AIYILIN/Robotic_Arm/2.Firmware/lckfb-hspi-d133ebs/readme.md

ui_builder
放置：
luban-lite\packages\artinchip\lvgl-ui\aic_demo\ui_builder
