AIYILIN/Robotic_Arm/6.Docs/unitree/GO-M8010-6电机使用教程/STM32平台教程/README.txt

1.本例程使用的单片机型号为STM32F767ZITx
2.使用本例程前需准备TTL转485模块(可在宇树官网或电商平台购买)
3.参考GO2电机TTL转485模组资料连接通信和电源线路
4.在使用其他单片机时需要先确认串口波特率是否满足4000000
5.对电机通信的文件进行移植
