AIYILIN/Robotic_Arm/2.Firmware/lckfb-hspi-d133ebs/aiui/AIUI_demo/resources/image/goodson.jpg

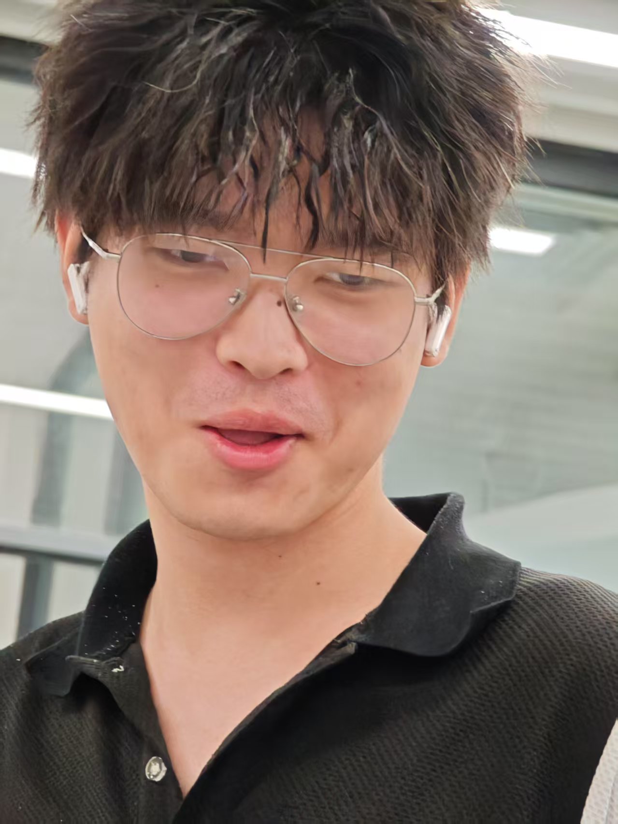
2.Firmware/lckfb-hspi-d133ebs/aiui/AIUI_demo/resources/image/goodson.jpg
