AIYILIN/Robotic_Arm/6.Docs/unitree/GO-M8010-6电机使用教程/STM32平台教程/GO2电机TTL转485模组资料/1_硬件开发资料_集成库文件/集成库全部器件3D预览2.jpg

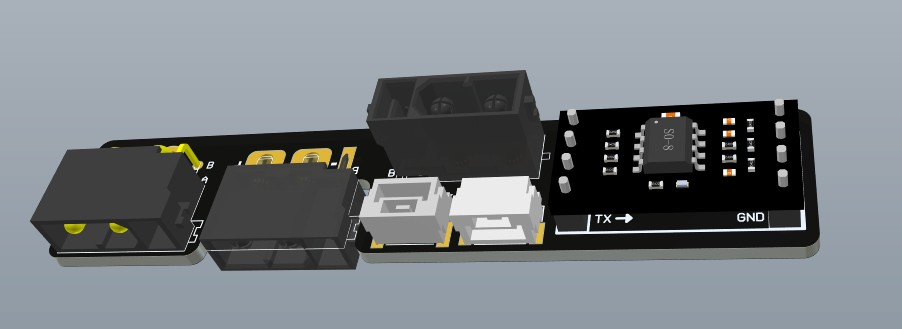
6.Docs/unitree/GO-M8010-6电机使用教程/STM32平台教程/GO2电机TTL转485模组资料/1_硬件开发资料_集成库文件/集成库全部器件3D预览2.jpg
