AIYILIN/Robotic_Arm/6.Docs/unitree/GO-M8010-6电机使用教程/STM32平台教程/GO2电机TTL转485模组资料/2_模组说明文档_附图/1-1A 模组应用接线示例.jpg

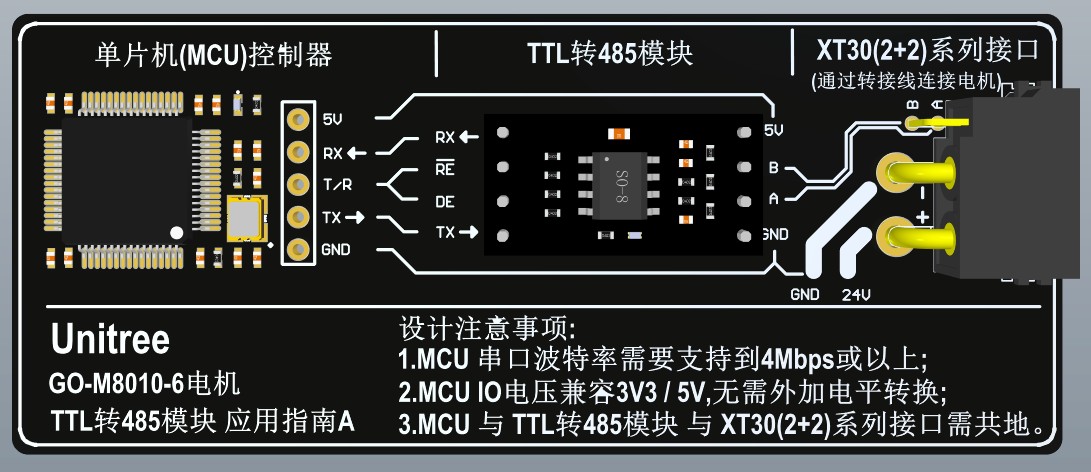
6.Docs/unitree/GO-M8010-6电机使用教程/STM32平台教程/GO2电机TTL转485模组资料/2_模组说明文档_附图/1-1A 模组应用接线示例.jpg
