AIYILIN/Robotic_Arm/6.Docs/unitree/GO-M8010-6电机使用教程/STM32平台教程/GO2电机TTL转485模组资料/2_模组说明文档_附图/1-3 模组TTL接口功能明细.png

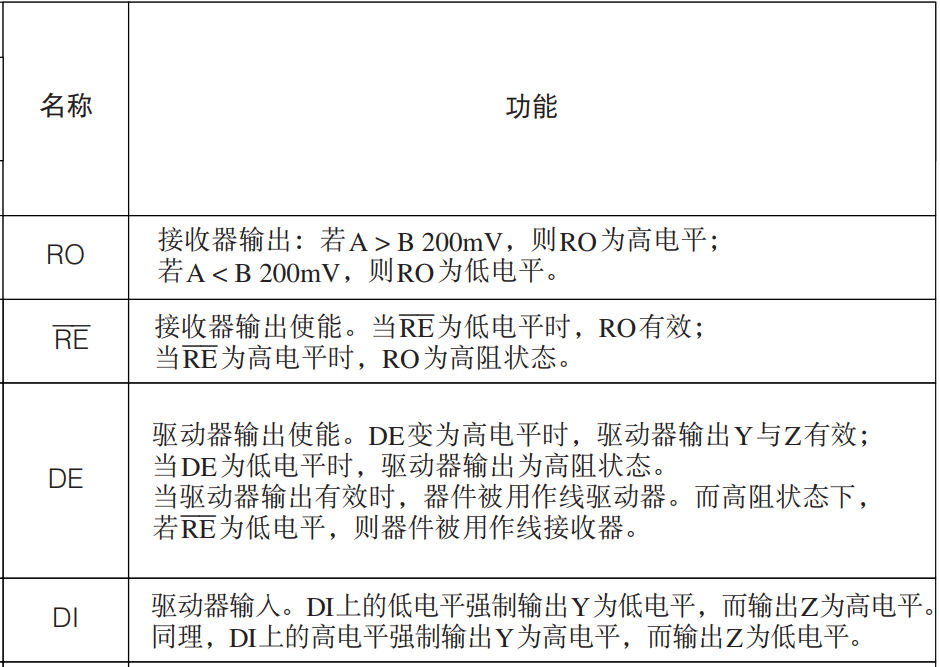
6.Docs/unitree/GO-M8010-6电机使用教程/STM32平台教程/GO2电机TTL转485模组资料/2_模组说明文档_附图/1-3 模组TTL接口功能明细.png
