AIYILIN/Robotic_Arm/5.3D Model/reducer-master/42/42电机减速机第四版/零件清单.xls

物料 | 数量
轴承 6706-ZZ【30*37*4】 | 1
轴承 内径12外径18厚度4 | 1
轴承 内径15外径21厚度4 | 1
注塑铜螺母滚花螺母 M3*6*4.2 | 10
注塑铜螺母滚花螺母 M2*6*3.2 | 4
钢圆头内六角螺丝圆柱螺钉 M2*35 (https://item.taobao.com/item.htm?spm=a1z09.2.0.0.6c082e8d8Twp98&id=664122354131&_u=ovv76ou61e7) | 4
3D 打印件
304不锈钢球轴承滚珠不锈钢钢珠实心钢珠精密小钢珠钢球2.0毫米 (https://item.taobao.com/item.htm?spm=a1z09.2.0.0.6c082e8dgtaKx1&id=617921831316&_u=qvv76oud0d6) | 45~55颗
润滑油 | 1
500目砂纸 | 1
