AIYILIN/Robotic_Arm/5.3D Model/reducer-master/42/42电机减速机第四版/42电机总成第四版底无轴.SLDASM

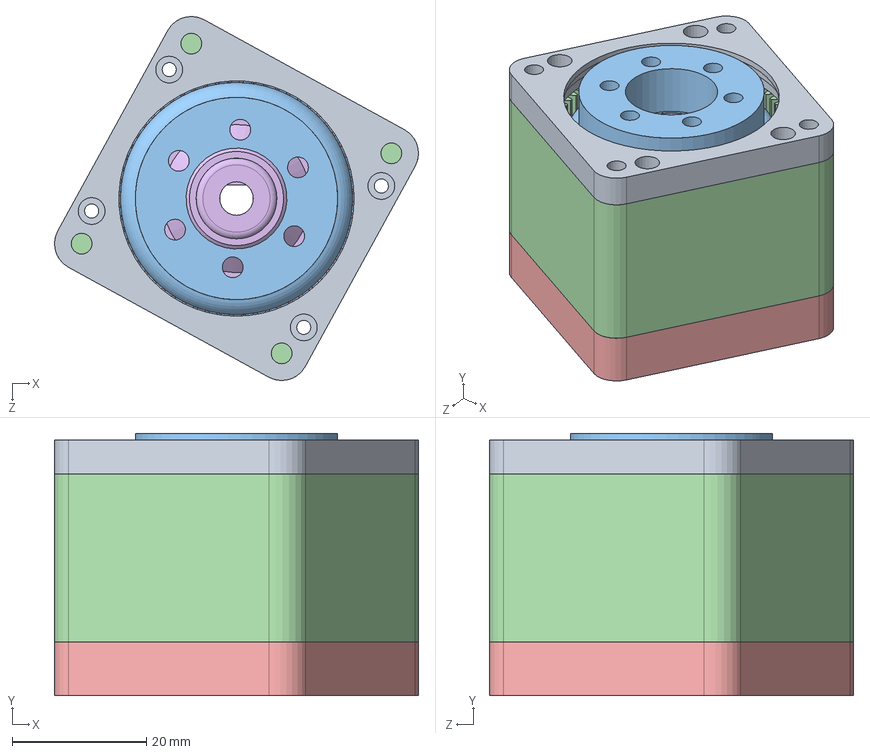
[picture p71: CAD file, 2025-01-31]
5.3D Model/reducer-master/42/42电机减速机第四版/42电机总成第四版底无轴.SLDASM
54.2 x 39.0 x 54.2 mm
42波发生器第四版底部中空
42底盖第四版
42钢轮第四版
42柔轮第四版
42柔轮内第四版
42顶盖第四版
