AIYILIN/Robotic_Arm/5.3D Model/reducer-master/28/28电机减速电机.SLDASM

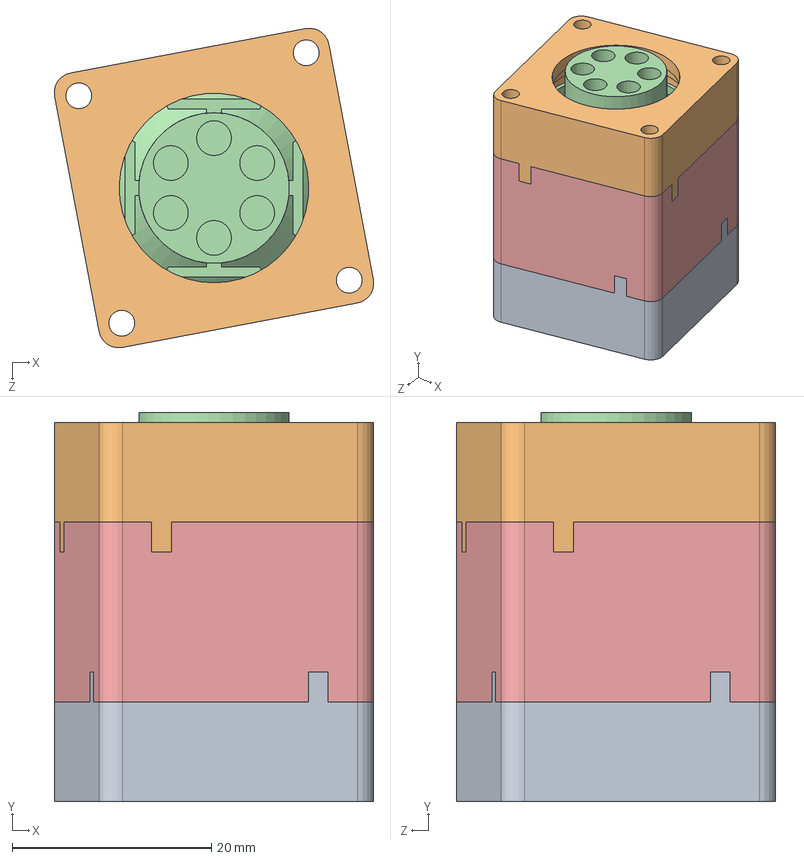
[picture p73: CAD file, 2025-01-31]
5.3D Model/reducer-master/28/28电机减速电机.SLDASM
32.0 x 39.0 x 32.0 mm
波发生器改
底座改
柔轮改
柔轮内改
顶盖改
底盖改
