AIYILIN/Robotic_Arm/5.3D Model/3-4轴连接.step

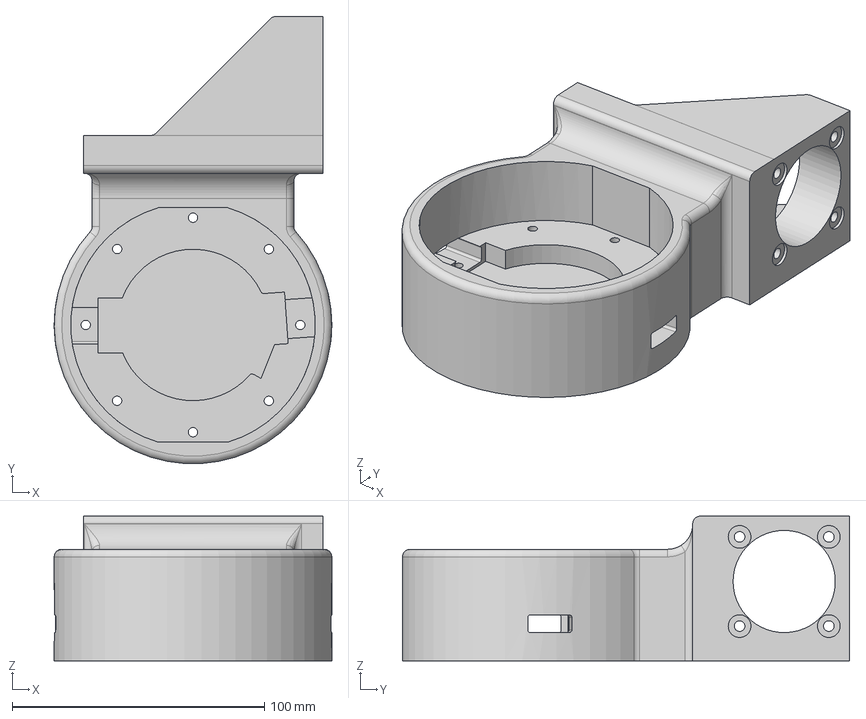
[picture p74: CAD file, 2025-02-12]
5.3D Model/3-4轴连接.step
110.0 x 177.1 x 57.3 mm
