AIYILIN/Robotic_Arm/5.3D Model/cnc/cnc2-3.step

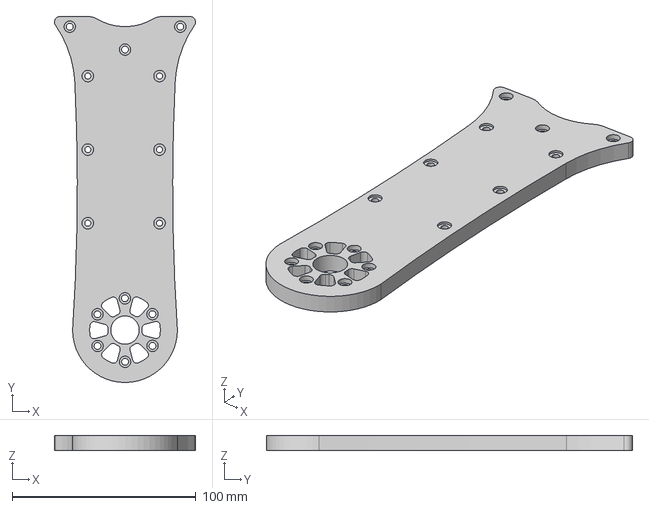
[picture p75: CAD file, 2025-02-06]
5.3D Model/cnc/cnc2-3.step
76.7 x 199.0 x 8.00 mm
