AIYILIN/Robotic_Arm/5.3D Model/reducer-master/42/42电机减速机第三版/42波发生器第三版.SLDPRT

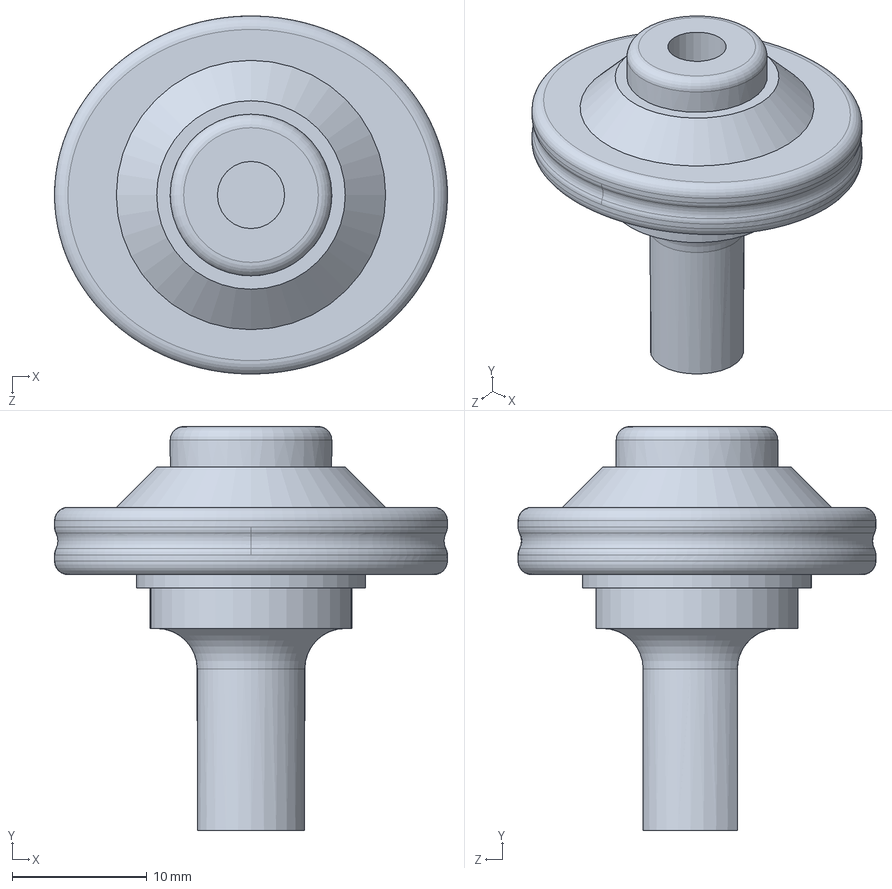
[picture p77: CAD file, 2025-01-31]
5.3D Model/reducer-master/42/42电机减速机第三版/42波发生器第三版.SLDPRT
29.2 x 30.0 x 26.6 mm
