AIYILIN/Robotic_Arm/5.3D Model/reducer-master/42/42电机减速机第三版/step/42减速器第三版总成.STEP

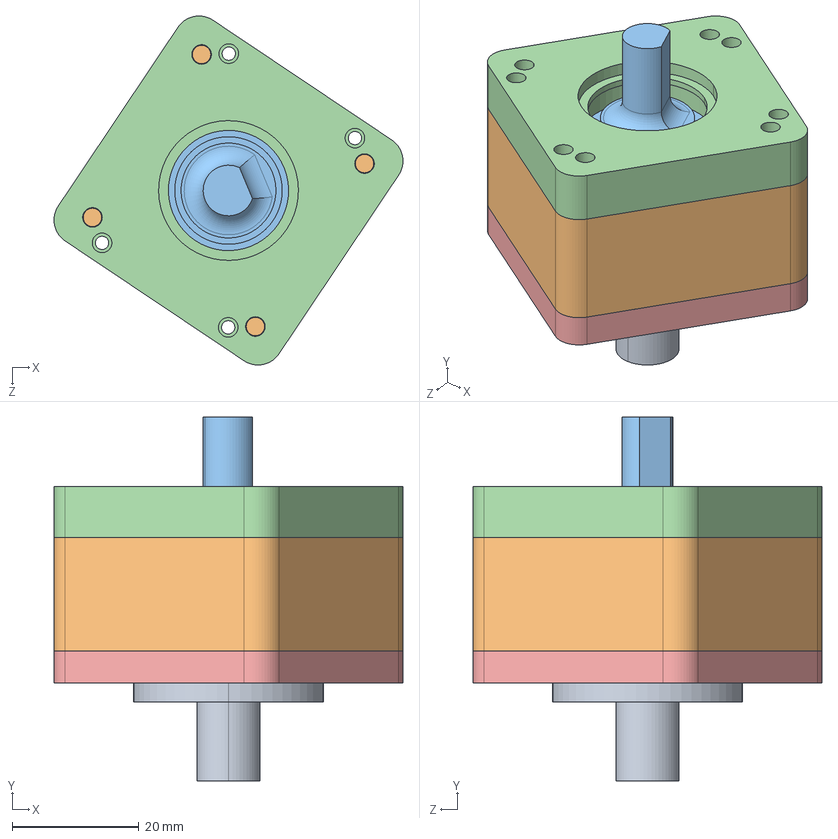
[picture p78: CAD file, 2025-01-31]
5.3D Model/reducer-master/42/42电机减速机第三版/step/42减速器第三版总成.STEP
55.2 x 57.5 x 55.2 mm
42柔轮第三版
42钢轮第三版
42波发生器第三版
42底盖第三版
42顶盖第三版
42柔轮内第三版
