AIYILIN/Robotic_Arm/5.3D Model/reducer-master/42/42电机减速机第二版/42顶盖第二版.SLDPRT

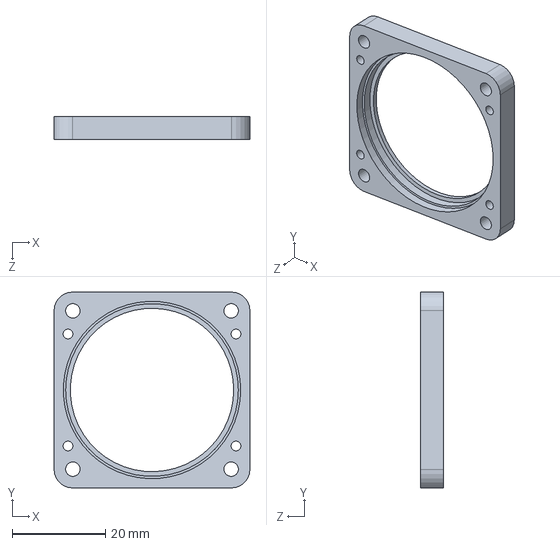
[picture p79: CAD file, 2025-01-31]
5.3D Model/reducer-master/42/42电机减速机第二版/42顶盖第二版.SLDPRT
42.0 x 42.0 x 5.00 mm
