AIYILIN/Robotic_Arm/5.3D Model/reducer-master/42/42电机减速机第二版/step/42减速器总成.STEP

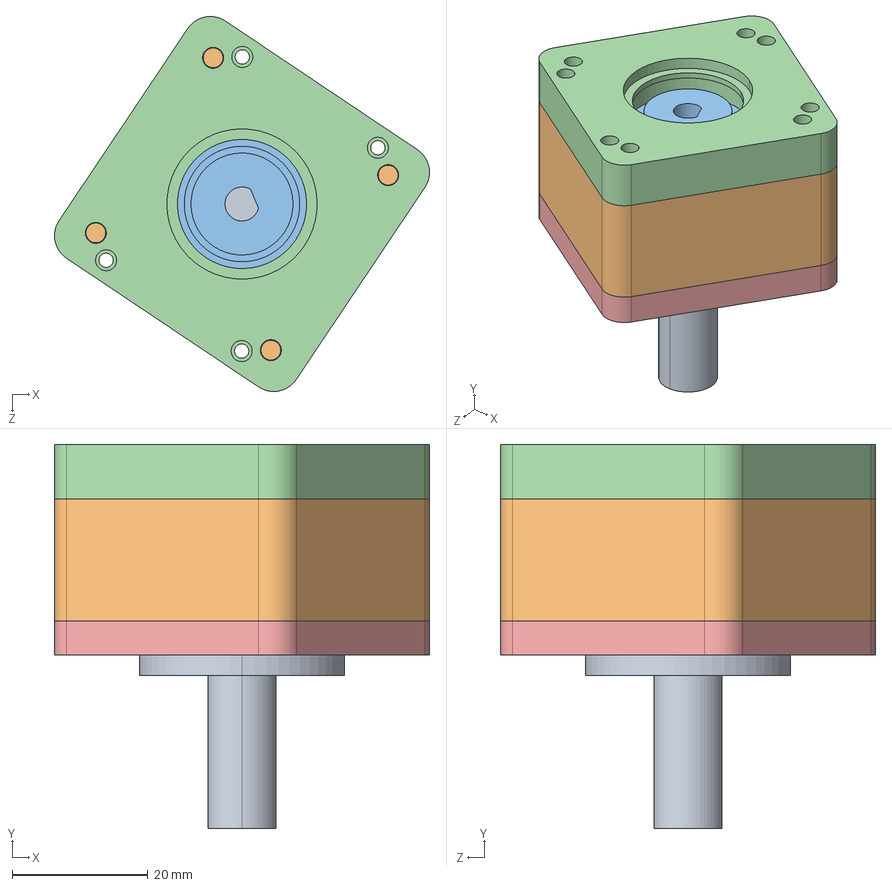
[picture p80: CAD file, 2025-01-31]
5.3D Model/reducer-master/42/42电机减速机第二版/step/42减速器总成.STEP
55.2 x 56.5 x 55.2 mm
42柔轮第二版
42钢轮第二版
42波发生器第二版
42底盖第二版
42顶盖第二版
42柔轮内第二版
