AIYILIN/Robotic_Arm/5.3D Model/reducer-master/42/42电机减速机第二版/stl/柔轮内.STL

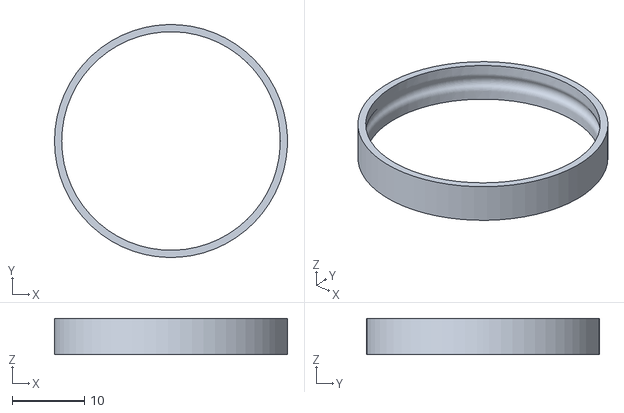
[picture p81: CAD file, 2025-01-31]
5.3D Model/reducer-master/42/42电机减速机第二版/stl/柔轮内.STL
32.2 x 32.2 x 5.00
