AIYILIN/Robotic_Arm/5.3D Model/手爪V1.0/顶端轴承固定件.SLDPRT

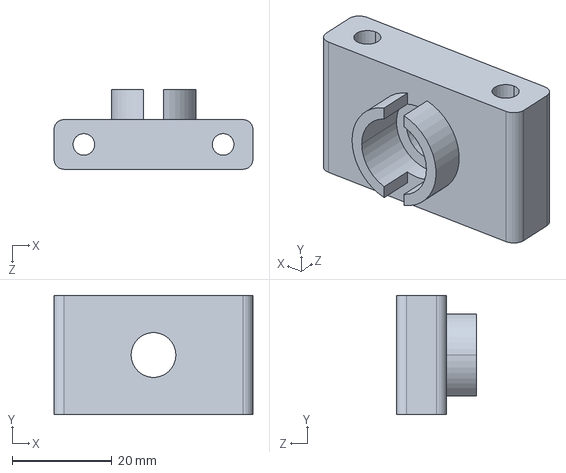
[picture p82: CAD file, 2025-05-13]
5.3D Model/手爪V1.0/顶端轴承固定件.SLDPRT
40.0 x 24.0 x 16.0 mm
