AIYILIN/Robotic_Arm/5.3D Model/拓竹/机械臂连杆 v2.step

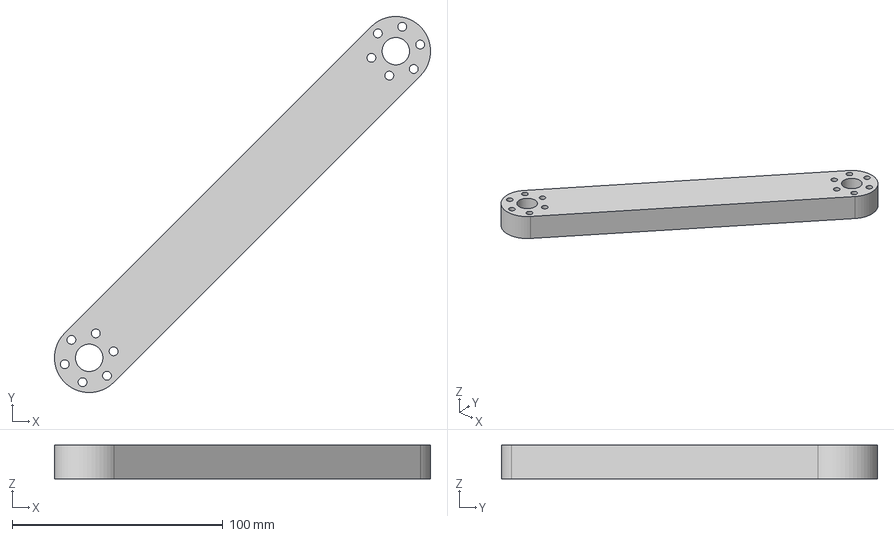
[picture p83: CAD file, 2025-01-31]
5.3D Model/拓竹/机械臂连杆 v2.step
178.5 x 178.5 x 16.0 mm
