AIYILIN/Robotic_Arm/6.Docs/CyberGear/电机三维图纸/CyberGearmotor.stp

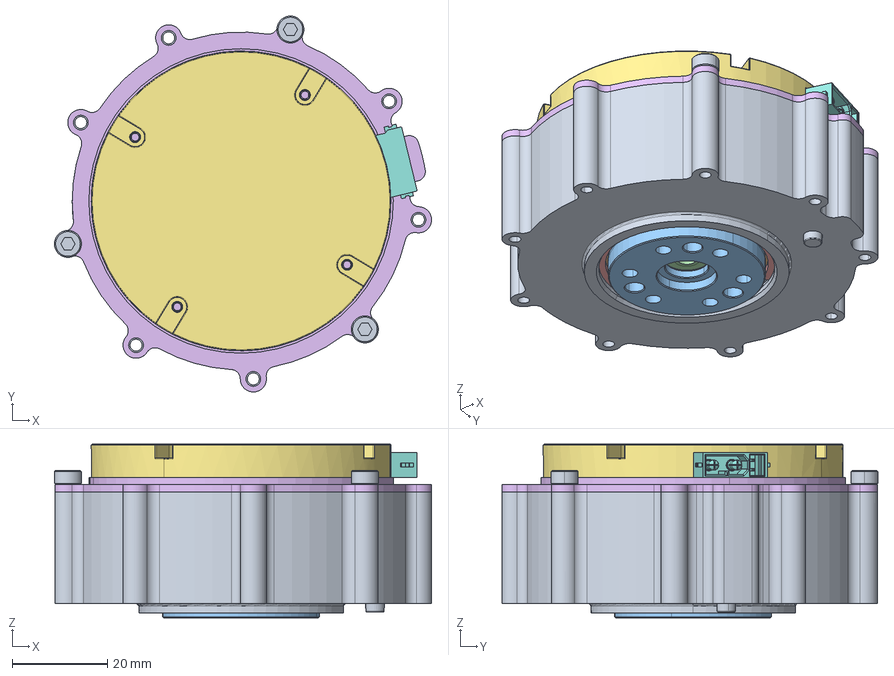
[picture p84: CAD file, 2025-01-31]
6.Docs/CyberGear/电机三维图纸/CyberGearmotor.stp
79.3 x 79.0 x 36.5 mm
1_1_06_EB673-504_1_1_1_1_1
1_1_02_EB671-500_1_1_1_1_1
1_1_31_QT-642_1_1_1_1_1
1_1_06_EB673-502_1_1_1_1_1
DUANZI_1_3_1_1_1_1_1_1
LUODING_1_1 x 3
