AIYILIN/Robotic_Arm/5.3D Model/cnc/cnc3-4.step

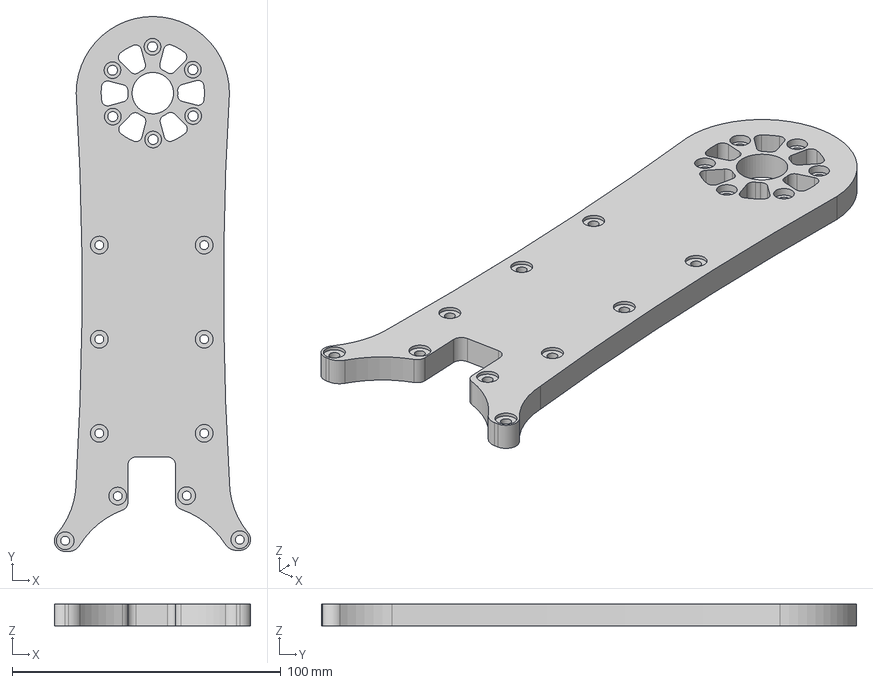
[picture p85: CAD file, 2025-02-06]
5.3D Model/cnc/cnc3-4.step
72.9 x 199.0 x 8.00 mm
