AIYILIN/Robotic_Arm/5.3D Model/reducer-master/28/底盖改.SLDPRT

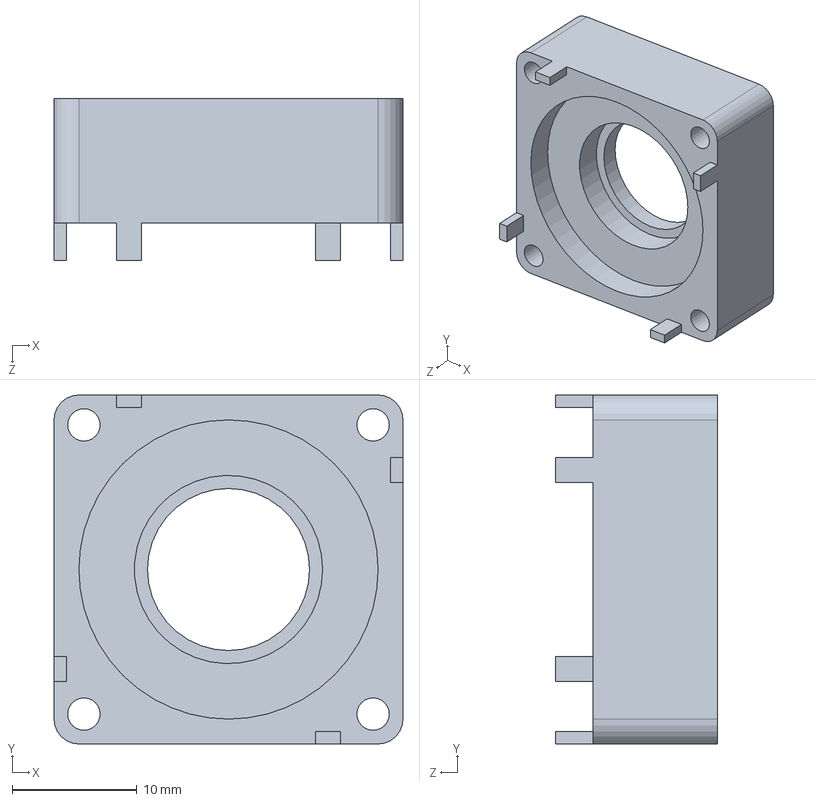
[picture p86: CAD file, 2025-01-31]
5.3D Model/reducer-master/28/底盖改.SLDPRT
28.0 x 28.0 x 13.0 mm
