AIYILIN/Robotic_Arm/5.3D Model/reducer-master/42/42电机减速机第二版/42波发生器第二版.SLDPRT

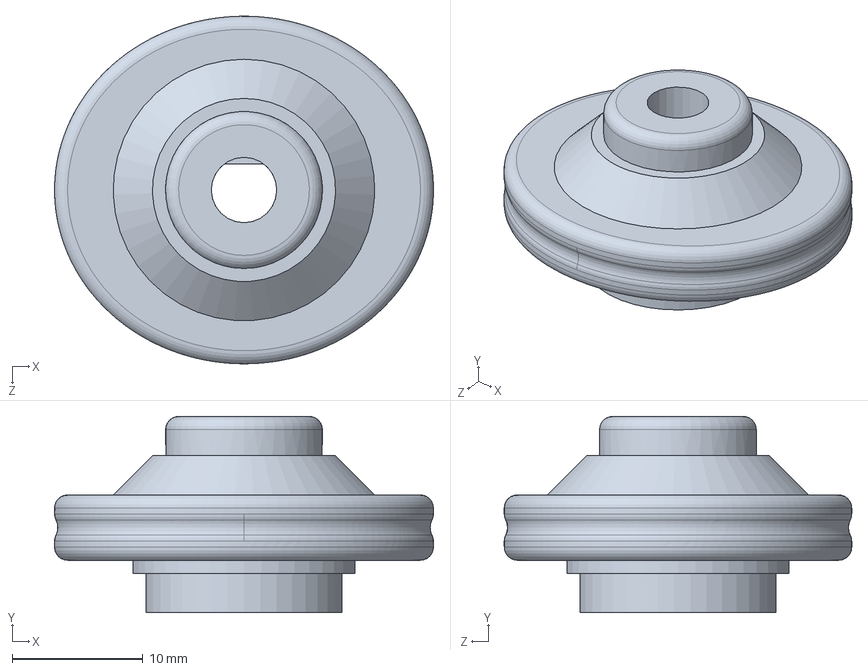
[picture p87: CAD file, 2025-01-31]
5.3D Model/reducer-master/42/42电机减速机第二版/42波发生器第二版.SLDPRT
29.0 x 15.0 x 26.6 mm
