AIYILIN/Robotic_Arm/5.3D Model/reducer-master/42/42电机减速机第四版/42钢轮第四版.SLDPRT

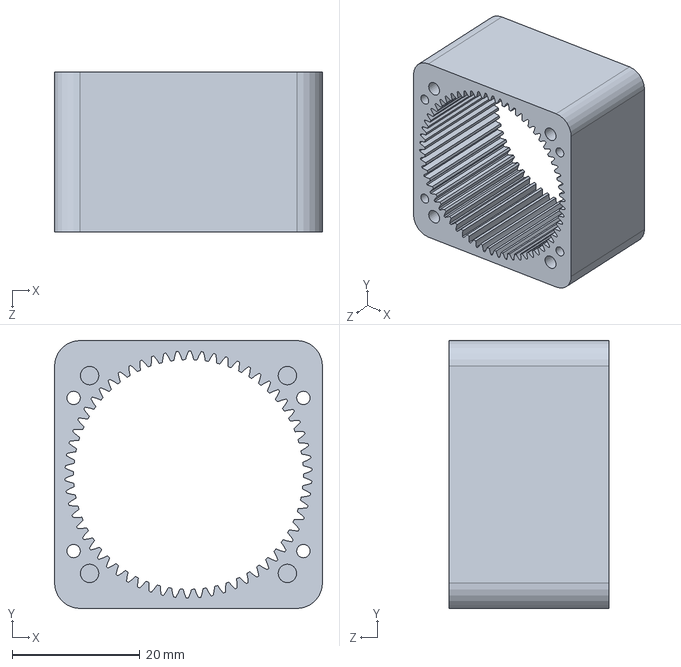
[picture p89: CAD file, 2025-01-31]
5.3D Model/reducer-master/42/42电机减速机第四版/42钢轮第四版.SLDPRT
42.0 x 42.0 x 25.0 mm
