AIYILIN/Robotic_Arm/5.3D Model/手爪V1.0/连杆1.SLDPRT

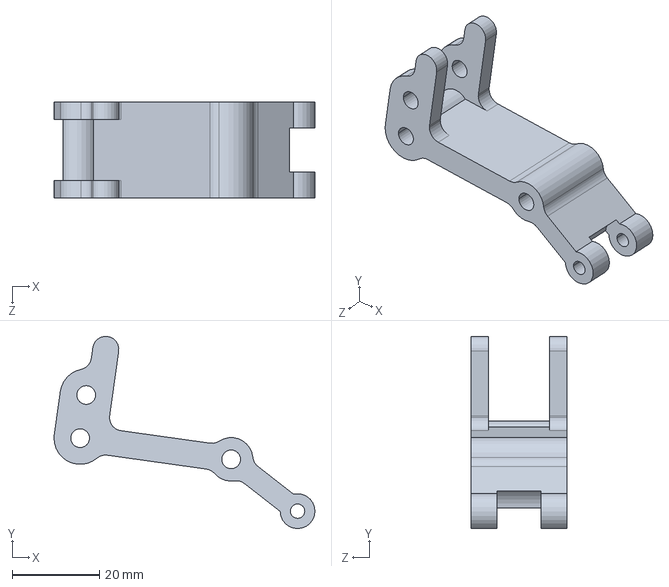
[picture p90: CAD file, 2025-05-13]
5.3D Model/手爪V1.0/连杆1.SLDPRT
59.9 x 44.1 x 22.0 mm
