AIYILIN/Robotic_Arm/5.3D Model/拓竹/1-2轴固定座.step

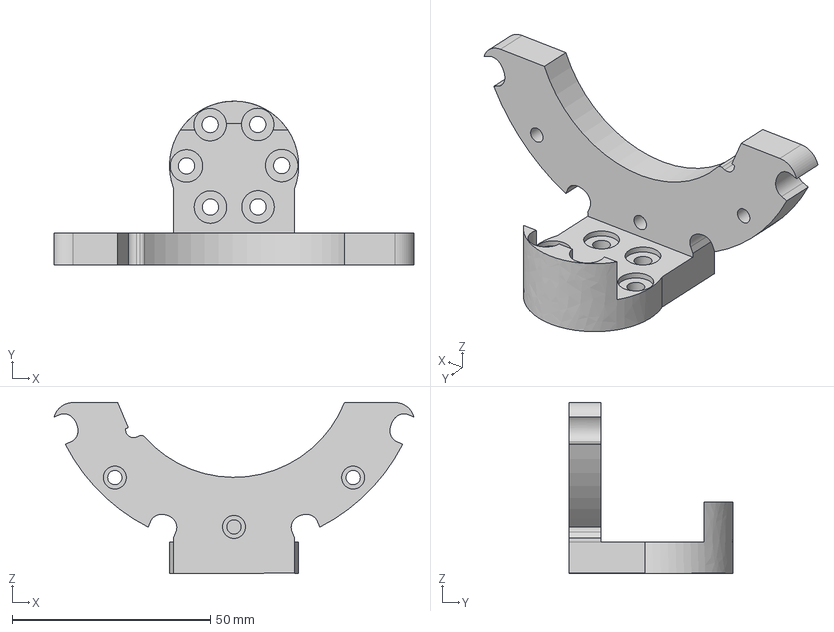
[picture p91: CAD file, 2025-01-31]
5.3D Model/拓竹/1-2轴固定座.step
90.8 x 41.3 x 43.1 mm
