AIYILIN/Robotic_Arm/5.3D Model/reducer-master/28/柔轮改.SLDPRT

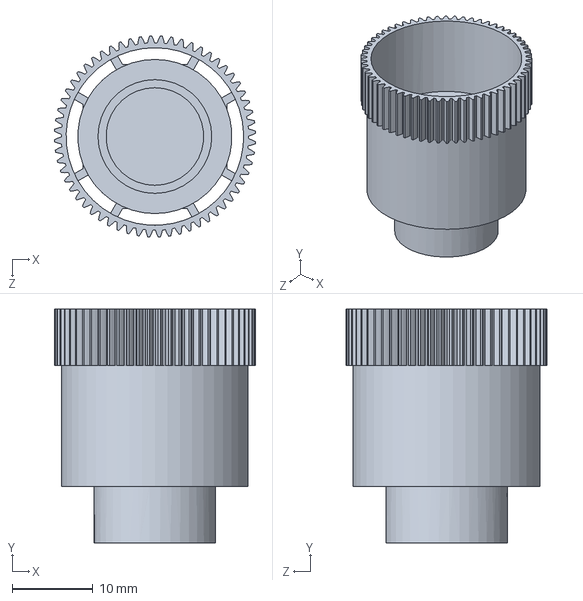
[picture p92: CAD file, 2025-01-31]
5.3D Model/reducer-master/28/柔轮改.SLDPRT
25.0 x 29.0 x 25.0 mm
