AIYILIN/Robotic_Arm/5.3D Model/手爪V1.0/侧杆1.SLDPRT

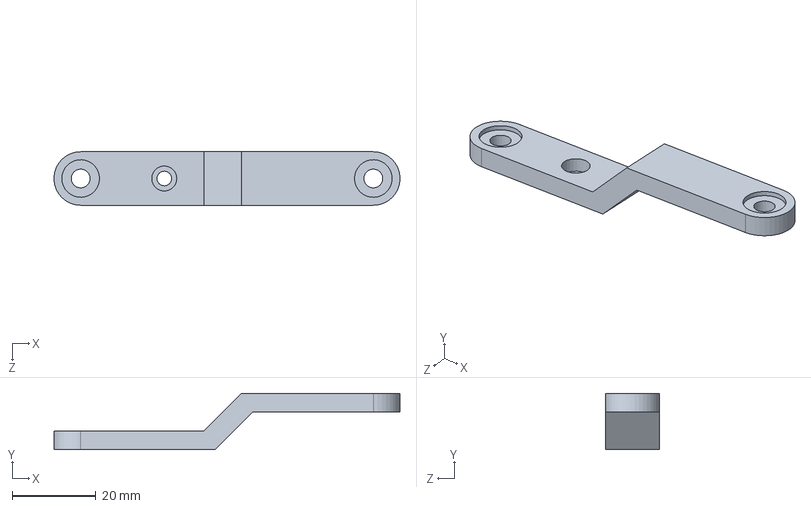
[picture p93: CAD file, 2025-05-13]
5.3D Model/手爪V1.0/侧杆1.SLDPRT
82.8 x 13.4 x 12.8 mm
