AIYILIN/Robotic_Arm/5.3D Model/拓竹/2-3轴固定座.step

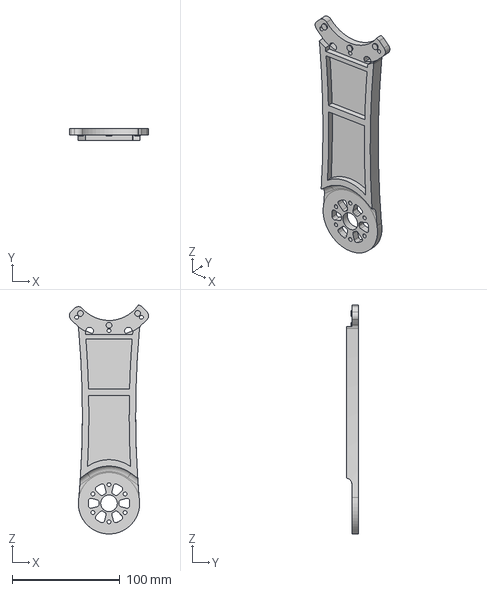
[picture p94: CAD file, 2025-01-31]
5.3D Model/拓竹/2-3轴固定座.step
73.5 x 11.0 x 212.4 mm
