AIYILIN/Robotic_Arm/5.3D Model/reducer-master/28/柔轮内改.SLDPRT

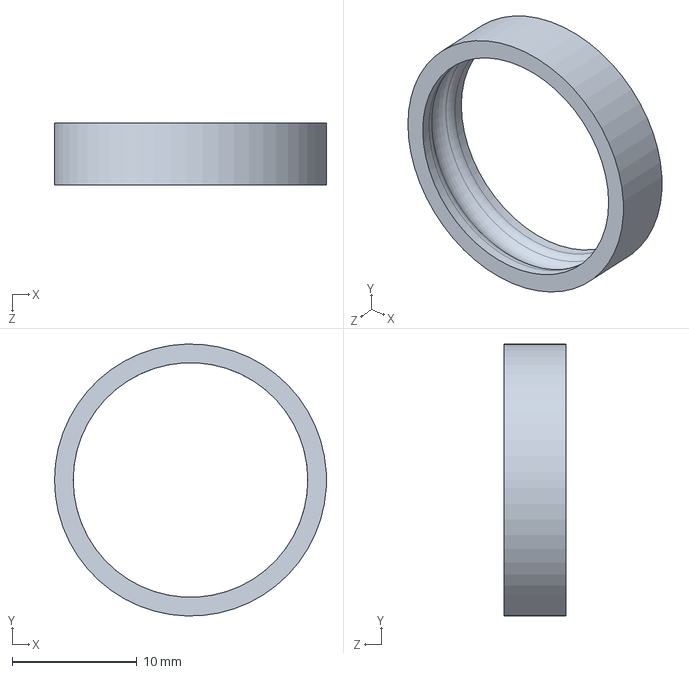
[picture p95: CAD file, 2025-01-31]
5.3D Model/reducer-master/28/柔轮内改.SLDPRT
21.8 x 21.8 x 5.00 mm
