AIYILIN/Robotic_Arm/5.3D Model/手爪V1.0/夹爪.STEP

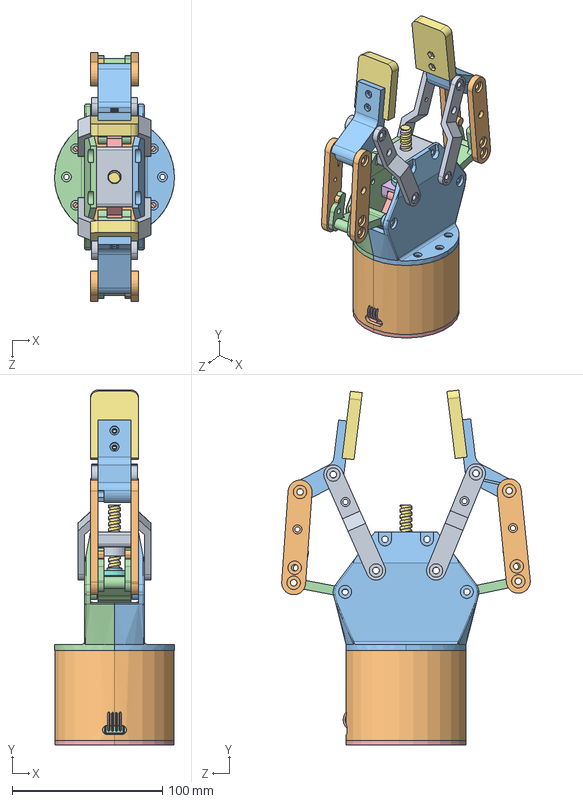
[picture p97: CAD file, 2025-05-13]
5.3D Model/手爪V1.0/夹爪.STEP
80.0 x 236.5 x 165.7 mm
丝杠42电机
侧杆1 x 4
侧杆2 x 4
夹爪 x 2
连杆1 x 2
连杆2 x 2
法兰转接件
夹爪面 x 2
T8螺母
顶端轴承固定件
电机固定壳
左外壳
右外壳
端盖
