AIYILIN/Robotic_Arm/5.3D Model/拓竹/3-4轴固定座.step

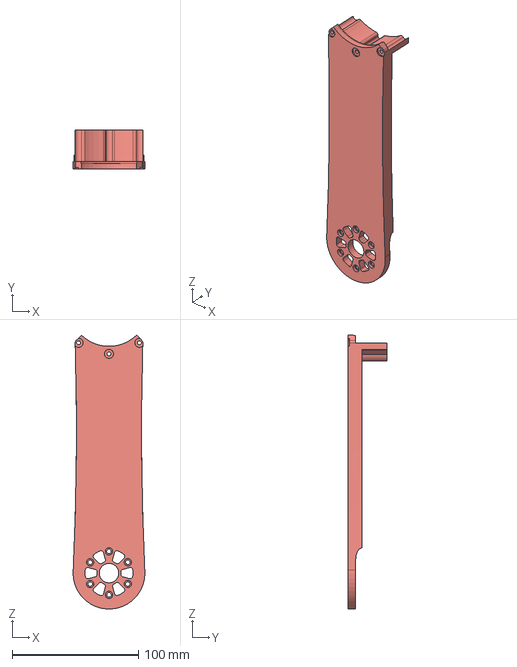
[picture p98: CAD file, 2025-01-31]
5.3D Model/拓竹/3-4轴固定座.step
57.0 x 31.0 x 217.3 mm
