AIYILIN/Robotic_Arm/5.3D Model/reducer-master/28/底座改.SLDPRT

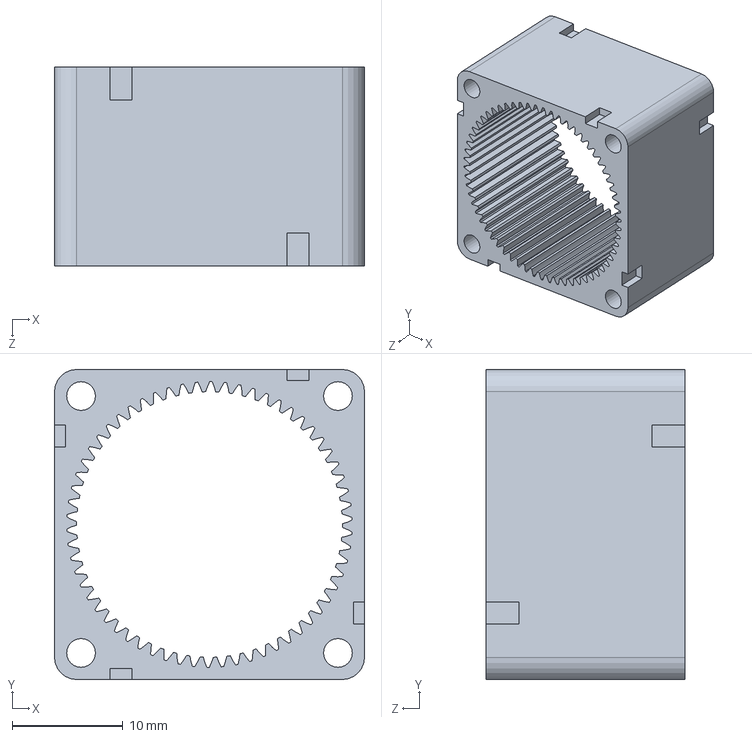
[picture p99: CAD file, 2025-01-31]
5.3D Model/reducer-master/28/底座改.SLDPRT
28.0 x 28.0 x 18.0 mm
