AIYILIN/Robotic_Arm/5.3D Model/reducer-master/42/42电机减速机第三版/42钢轮第三版.SLDPRT

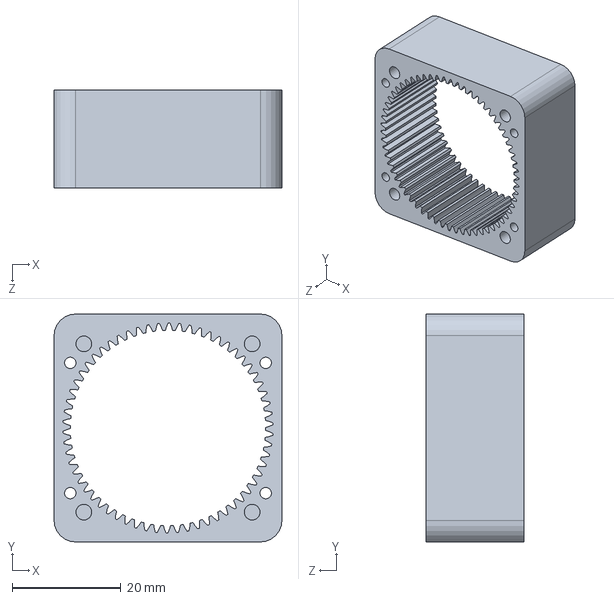
[picture p100: CAD file, 2025-01-31]
5.3D Model/reducer-master/42/42电机减速机第三版/42钢轮第三版.SLDPRT
42.0 x 42.0 x 18.0 mm
