AIYILIN/Robotic_Arm/5.3D Model/reducer-master/42/42电机减速机第二版/stl/柔轮.STL

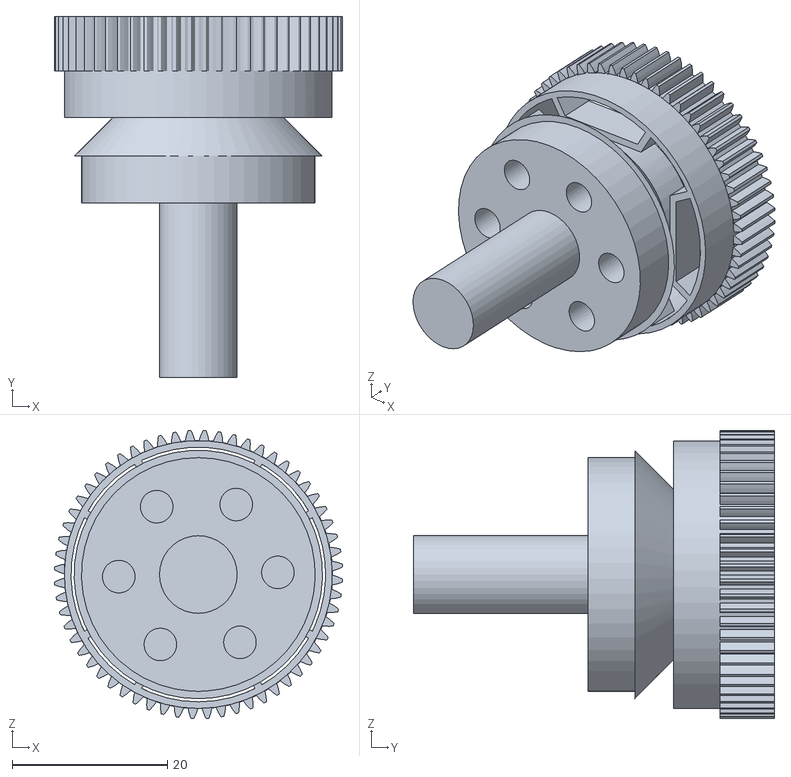
[picture p101: CAD file, 2025-01-31]
5.3D Model/reducer-master/42/42电机减速机第二版/stl/柔轮.STL
37.1 x 46.5 x 37.1
