AIYILIN/Robotic_Arm/5.3D Model/reducer-master/42/42电机减速机第四版/42波发生器第四版底部中空.SLDPRT

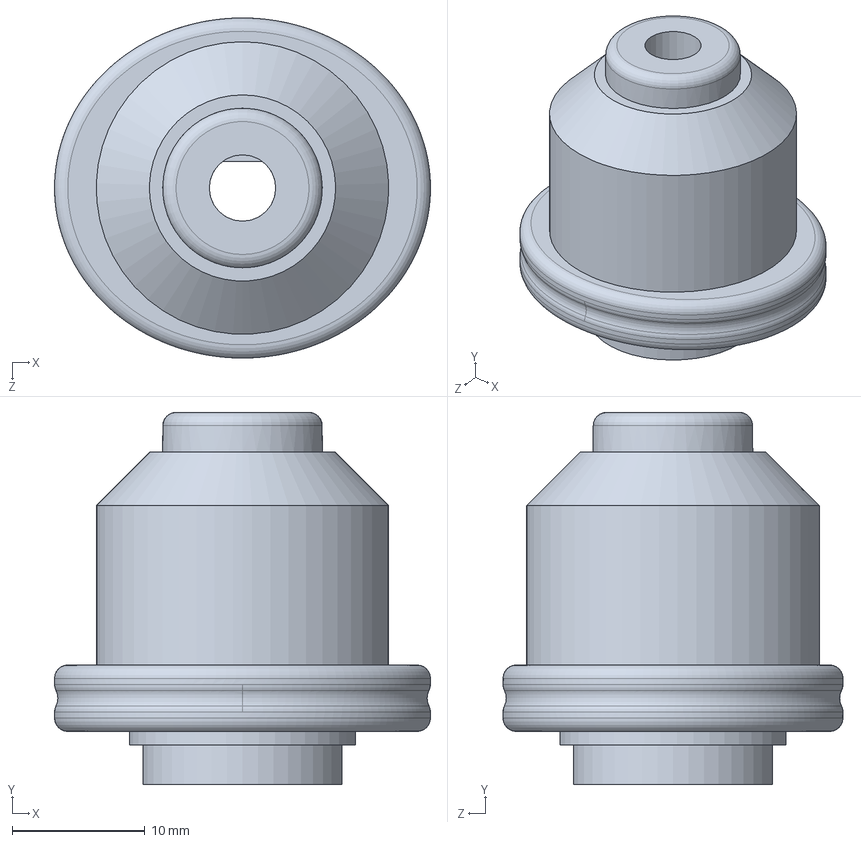
[picture p102: CAD file, 2025-01-31]
5.3D Model/reducer-master/42/42电机减速机第四版/42波发生器第四版底部中空.SLDPRT
28.3 x 28.0 x 25.6 mm
