AIYILIN/Robotic_Arm/5.3D Model/手爪V1.0/连杆2.SLDPRT

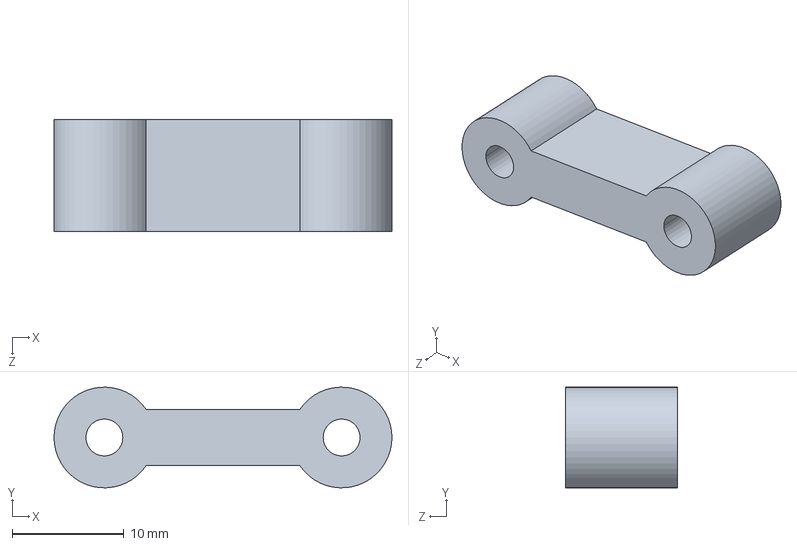
[picture p103: CAD file, 2025-05-13]
5.3D Model/手爪V1.0/连杆2.SLDPRT
30.2 x 8.99 x 10.0 mm
