AIYILIN/Robotic_Arm/5.3D Model/reducer-master/28/波发生器改.SLDPRT

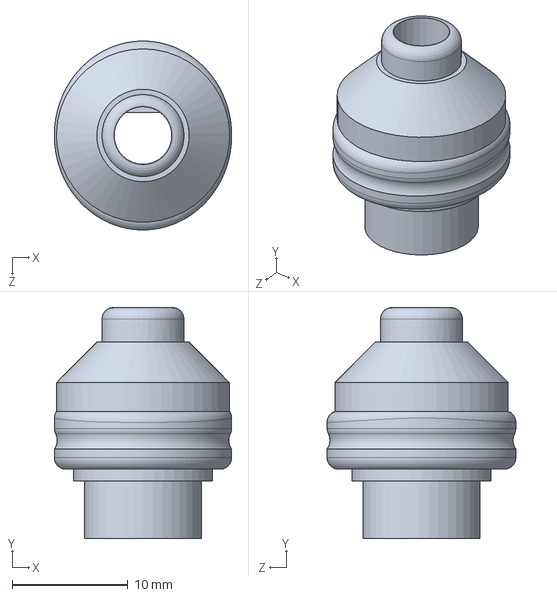
[picture p104: CAD file, 2025-01-31]
5.3D Model/reducer-master/28/波发生器改.SLDPRT
15.4 x 20.0 x 16.4 mm
