AIYILIN/Robotic_Arm/5.3D Model/reducer-master/42/42电机减速机第三版/42柔轮第三版.SLDPRT

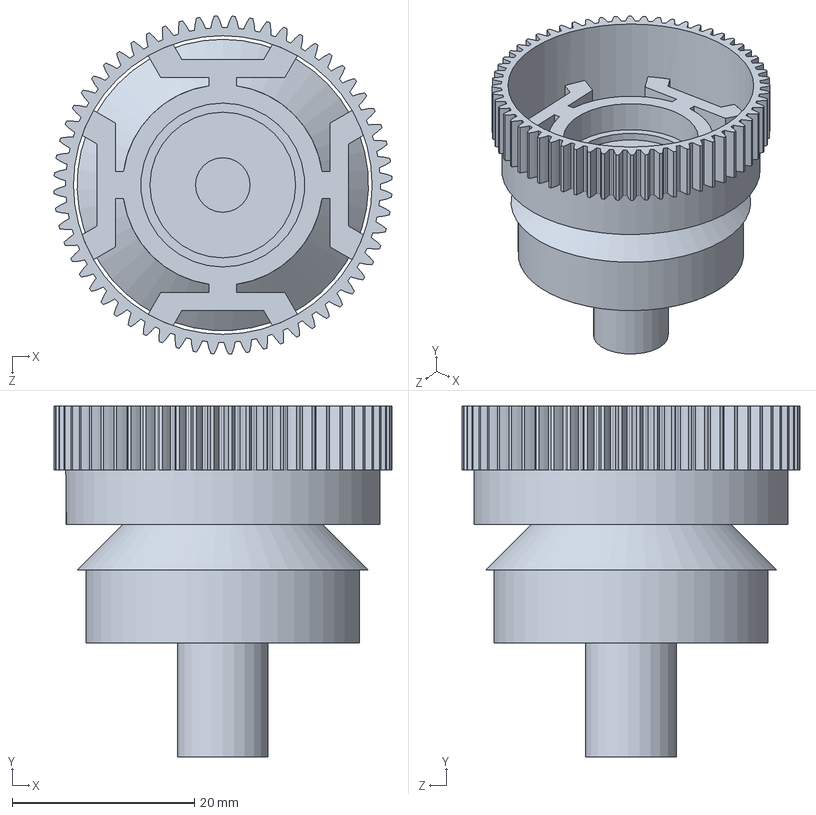
[picture p105: CAD file, 2025-01-31]
5.3D Model/reducer-master/42/42电机减速机第三版/42柔轮第三版.SLDPRT
37.1 x 38.5 x 37.1 mm
