AIYILIN/Robotic_Arm/5.3D Model/reducer-master/42/42电机减速机第二版/42柔轮第二版.SLDPRT

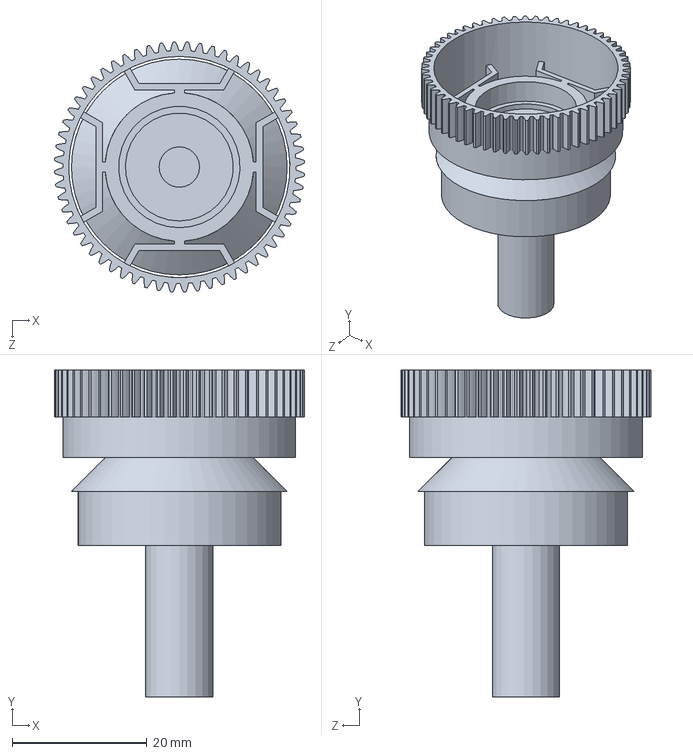
[picture p106: CAD file, 2025-01-31]
5.3D Model/reducer-master/42/42电机减速机第二版/42柔轮第二版.SLDPRT
37.1 x 48.5 x 37.1 mm
