AIYILIN/Robotic_Arm/5.3D Model/reducer-master/42/42电机减速机第二版/stl/钢轮.STL

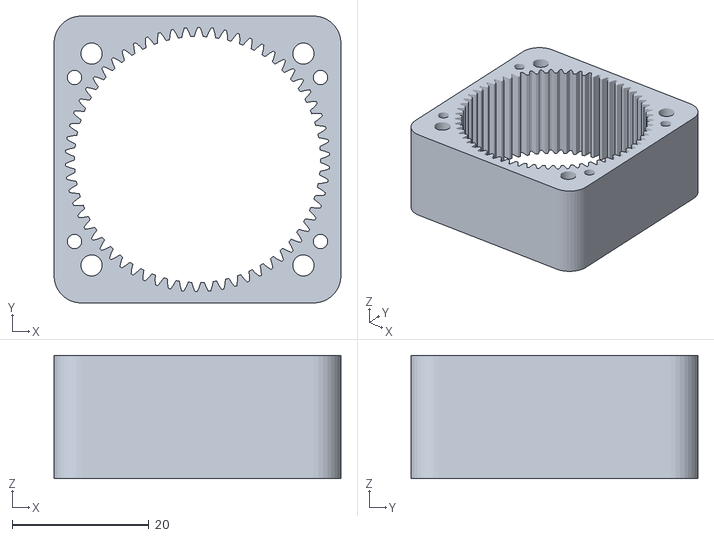
[picture p107: CAD file, 2025-01-31]
5.3D Model/reducer-master/42/42电机减速机第二版/stl/钢轮.STL
42.0 x 42.0 x 18.0
