AIYILIN/Robotic_Arm/5.3D Model/reducer-master/42/42电机减速机第四版/42顶盖第四版长2mm.SLDPRT

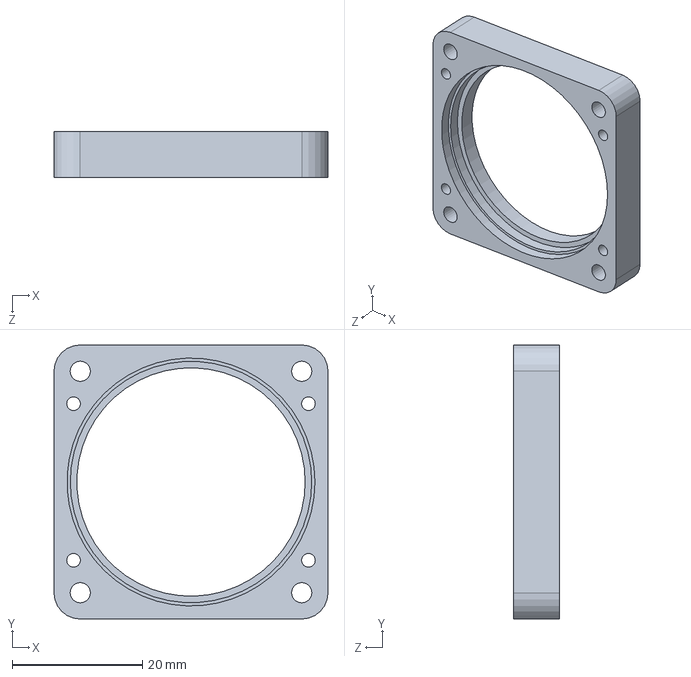
[picture p108: CAD file, 2025-01-31]
5.3D Model/reducer-master/42/42电机减速机第四版/42顶盖第四版长2mm.SLDPRT
42.0 x 42.0 x 7.00 mm
