AIYILIN/Robotic_Arm/5.3D Model/手爪V1.0/侧杆2.SLDPRT

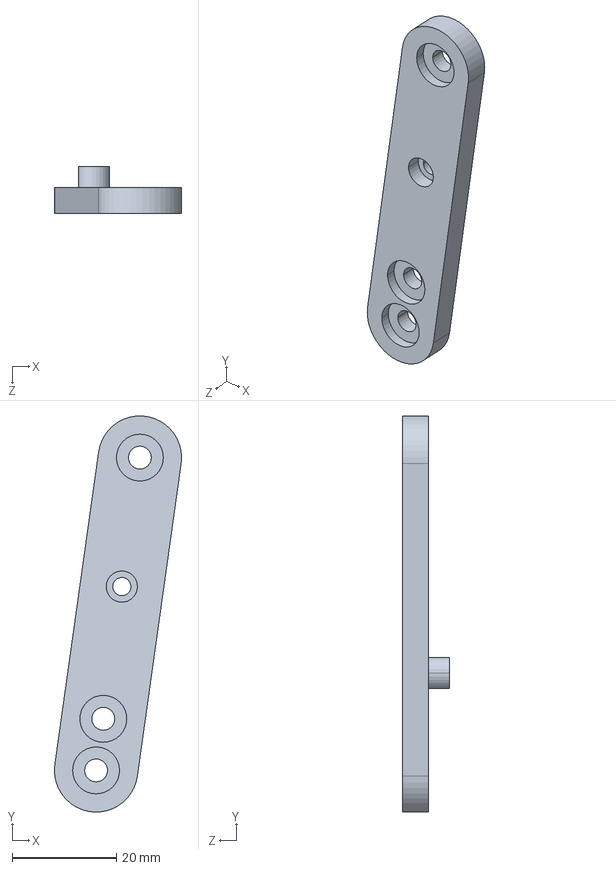
[picture p109: CAD file, 2025-05-13]
5.3D Model/手爪V1.0/侧杆2.SLDPRT
24.4 x 76.0 x 9.00 mm
