AIYILIN/Robotic_Arm/5.3D Model/拓竹/底座-1轴固定座.step

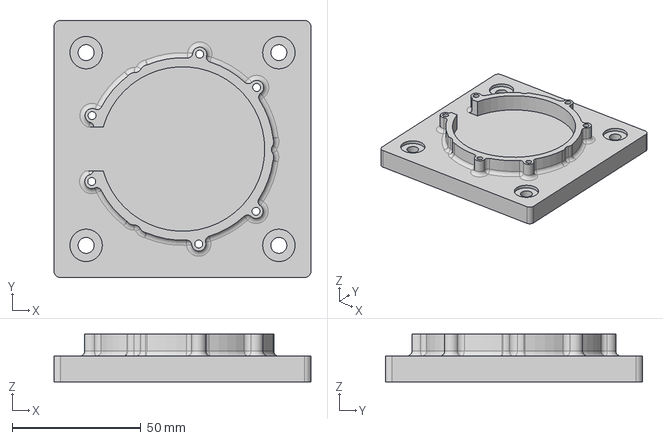
[picture p110: CAD file, 2025-01-31]
5.3D Model/拓竹/底座-1轴固定座.step
100.0 x 100.0 x 18.5 mm
