AIYILIN/Robotic_Arm/5.3D Model/reducer-master/42/42电机减速机第四版/42波发生器第四版.SLDPRT

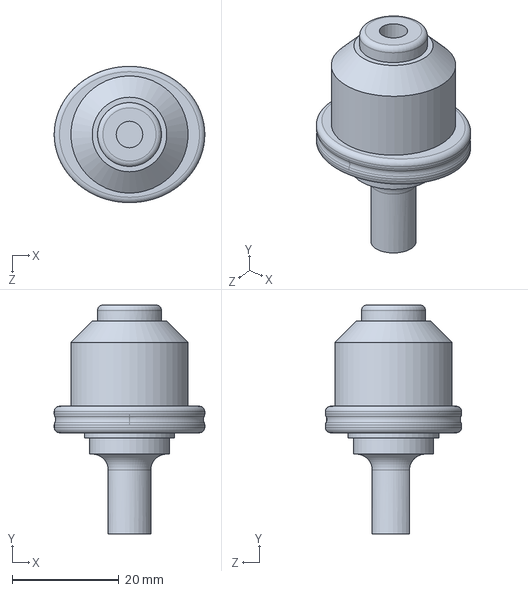
[picture p111: CAD file, 2025-01-31]
5.3D Model/reducer-master/42/42电机减速机第四版/42波发生器第四版.SLDPRT
28.3 x 43.0 x 25.6 mm
