AIYILIN/Robotic_Arm/5.3D Model/手爪V1.0/夹爪面.SLDPRT

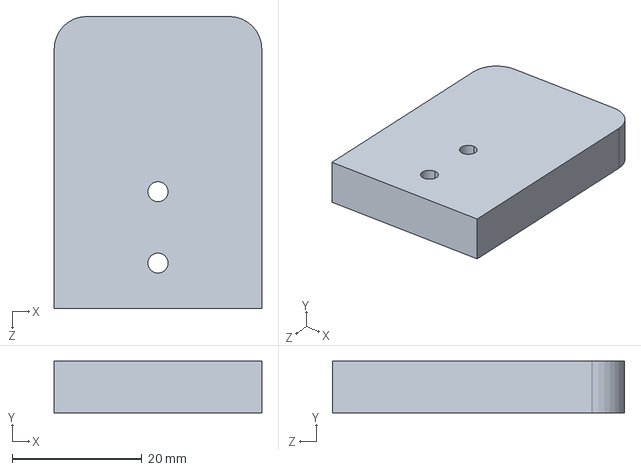
[picture p112: CAD file, 2025-05-13]
5.3D Model/手爪V1.0/夹爪面.SLDPRT
32.0 x 8.00 x 45.0 mm
