AIYILIN/Robotic_Arm/5.3D Model/reducer-master/42/42电机减速机第四版/42柔轮第四版.SLDPRT

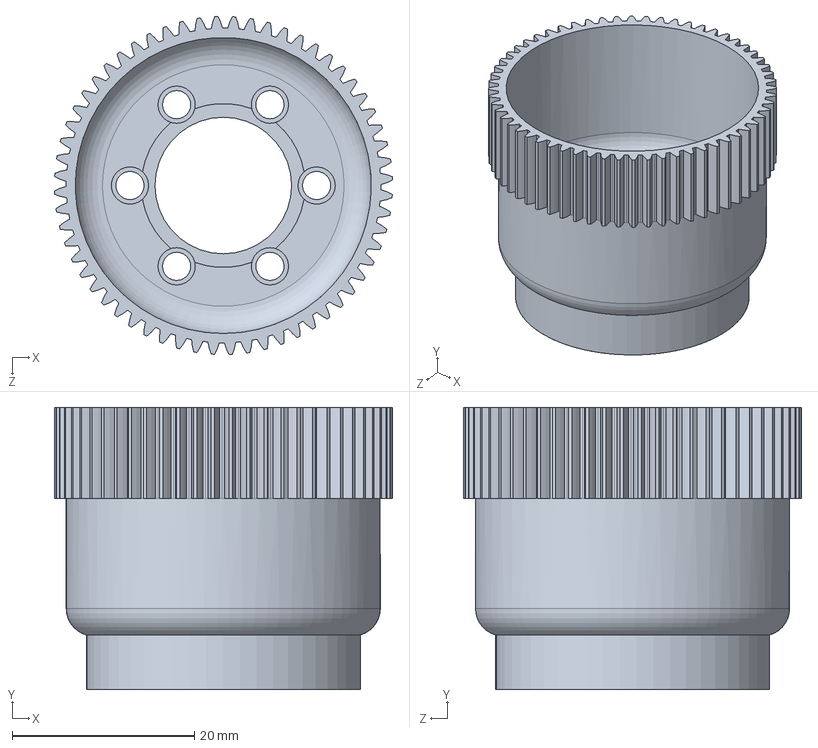
[picture p113: CAD file, 2025-01-31]
5.3D Model/reducer-master/42/42电机减速机第四版/42柔轮第四版.SLDPRT
37.1 x 31.0 x 37.1 mm
