AIYILIN/Robotic_Arm/5.3D Model/手爪V1.0/右外壳.SLDPRT

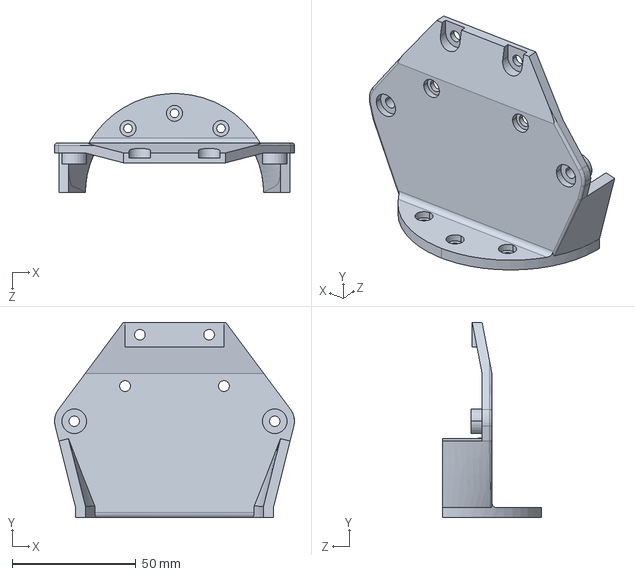
[picture p114: CAD file, 2025-05-13]
5.3D Model/手爪V1.0/右外壳.SLDPRT
97.1 x 79.0 x 40.0 mm
