AIYILIN/Robotic_Arm/5.3D Model/手爪V1.0/电机固定壳.SLDPRT

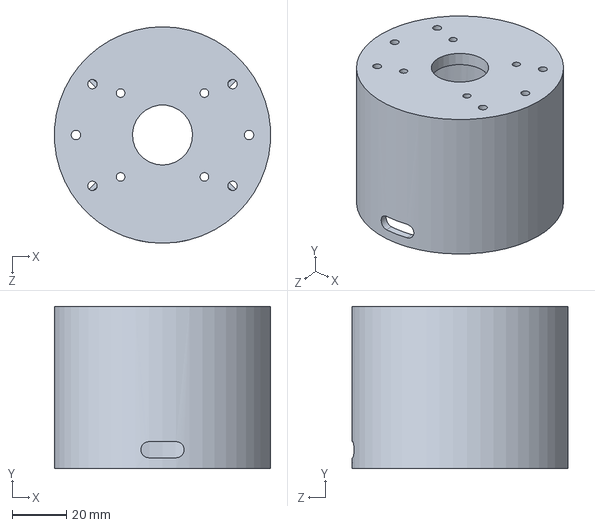
[picture p115: CAD file, 2025-05-13]
5.3D Model/手爪V1.0/电机固定壳.SLDPRT
79.8 x 60.0 x 80.0 mm
