AIYILIN/Robotic_Arm/5.3D Model/手爪V1.0/端盖.SLDPRT

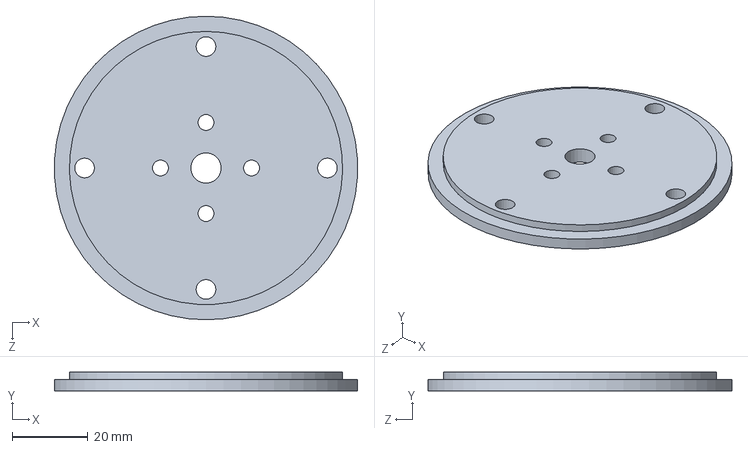
[picture p116: CAD file, 2025-05-13]
5.3D Model/手爪V1.0/端盖.SLDPRT
79.9 x 5.00 x 80.0 mm
