AIYILIN/Robotic_Arm/5.3D Model/reducer-master/42/42电机减速机第四版/42柔轮内第四版.SLDPRT

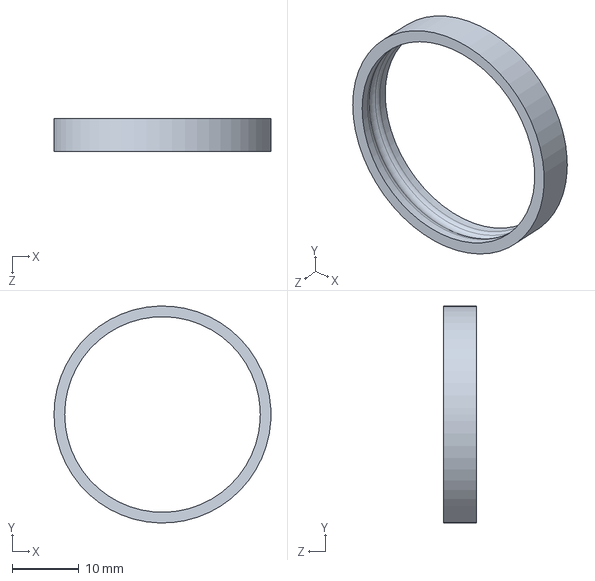
[picture p117: CAD file, 2025-01-31]
5.3D Model/reducer-master/42/42电机减速机第四版/42柔轮内第四版.SLDPRT
32.4 x 32.4 x 5.00 mm
