AIYILIN/Robotic_Arm/5.3D Model/手爪V1.0/法兰转接件.SLDPRT

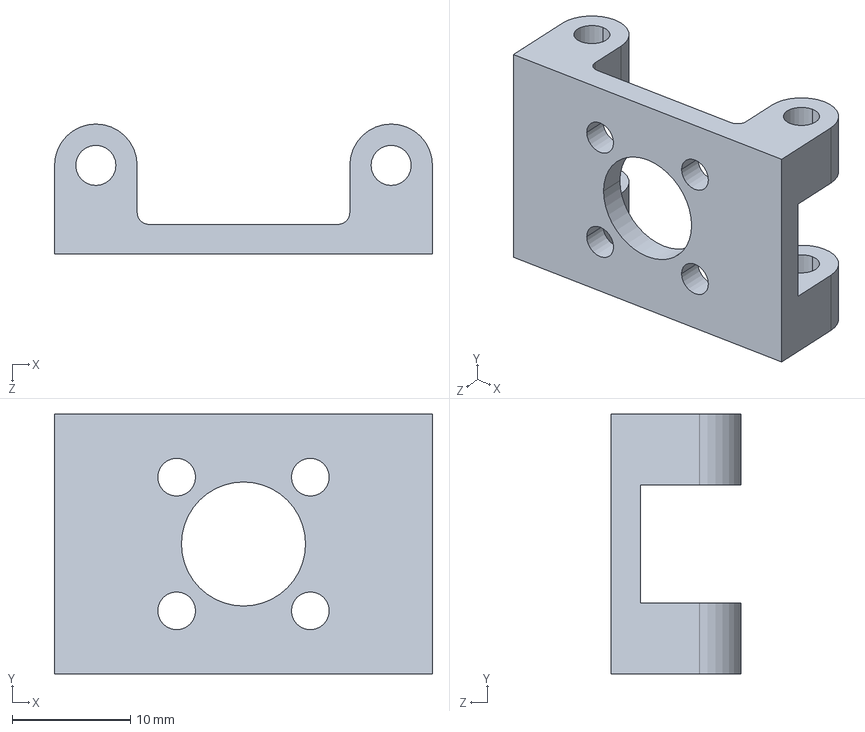
[picture p118: CAD file, 2025-05-13]
5.3D Model/手爪V1.0/法兰转接件.SLDPRT
32.0 x 22.0 x 11.0 mm
