AIYILIN/Robotic_Arm/5.3D Model/手爪V1.0/T8螺母.SLDPRT

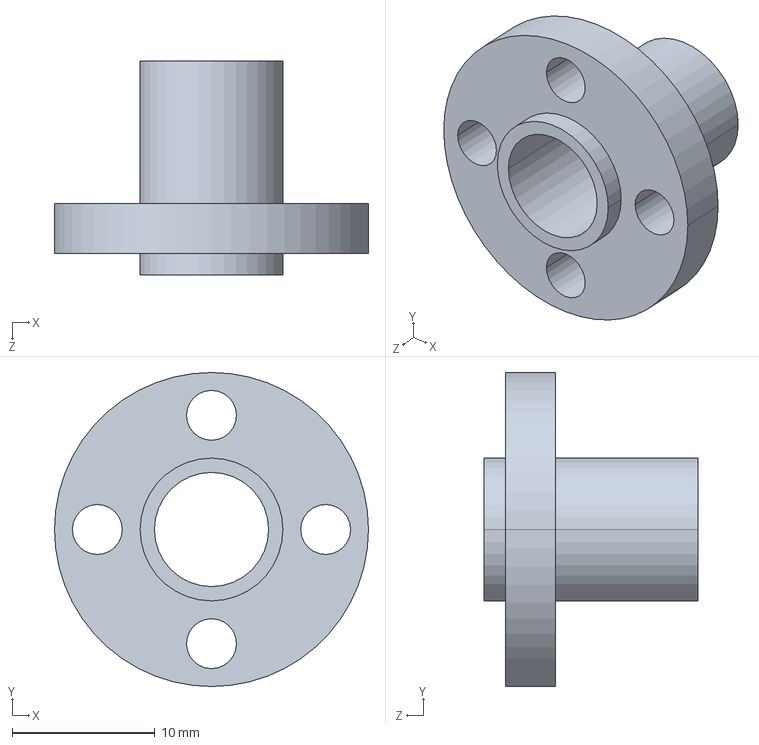
[picture p119: CAD file, 2025-05-13]
5.3D Model/手爪V1.0/T8螺母.SLDPRT
22.0 x 22.0 x 15.0 mm
