AIYILIN/Robotic_Arm/5.3D Model/手爪V1.0/丝杠42电机.SLDPRT

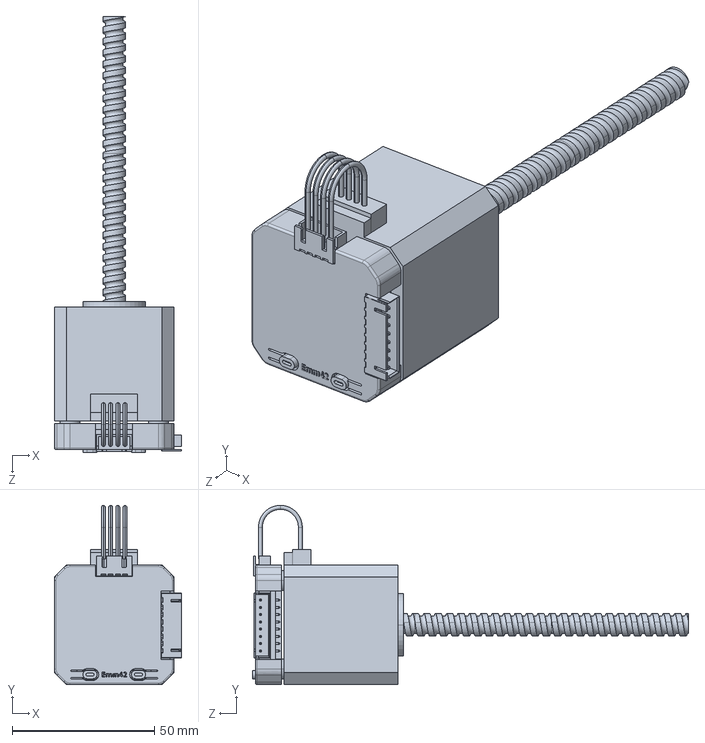
[picture p120: CAD file, 2025-05-13]
5.3D Model/手爪V1.0/丝杠42电机.SLDPRT
44.6 x 62.9 x 153.0 mm
