AIYILIN/Robotic_Arm/(list of files, cad)

Other CAD files:
6.Docs/1.47/02-1.47IPS程序源码/01-1.47IPS显示屏C51_SPI例程/main.OBJ
5.3D Model/reducer-master/42/42电机减速机第四版/STL/42钢轮第四版111.3mf
6.Docs/1.47/02-1.47IPS程序源码/01-1.47IPS显示屏C51_SPI例程/lcd.obj
5.3D Model/reducer-master/42/42电机减速机第三版/42顶盖第三版.SLDPRT
6.Docs/1.47/02-1.47IPS程序源码/01-1.47IPS显示屏C51_SPI例程/STARTUP.OBJ
5.3D Model/reducer-master/42/42电机减速机第三版/42柔轮内第三版.SLDPRT
5.3D Model/reducer-master/42/42电机减速机第二版/42柔轮内第二版.SLDPRT
5.3D Model/reducer-master/42/42电机减速机第二版/stl/波发生器.STL
6.Docs/1.47/02-1.47IPS程序源码/01-1.47IPS显示屏C51_SPI例程/lcd_init.obj
5.3D Model/reducer-master/42/42电机减速机第三版/42底盖第三版.SLDPRT
5.3D Model/reducer-master/42/42电机减速机第二版/42底盖第二版.SLDPRT
5.3D Model/reducer-master/42/42电机减速机第二版/stl/顶盖.STL
5.3D Model/reducer-master/42/42电机减速机第二版/42钢轮第二版.SLDPRT
5.3D Model/reducer-master/42/42电机减速机第四版/42底盖第四版.SLDPRT
5.3D Model/reducer-master/42/42电机减速机第四版/42顶盖第四版.SLDPRT
5.3D Model/手爪V1.0/左外壳.SLDPRT
5.3D Model/reducer-master/42/42电机减速机第三版/42减速器第三版总成.SLDASM
5.3D Model/reducer-master/42/42电机减速机第三版/stl/42底盖第三版.STL
5.3D Model/reducer-master/42/42电机减速机第三版/stl/42柔轮内第三版.STL
5.3D Model/reducer-master/42/42电机减速机第三版/stl/42柔轮第三版.STL
5.3D Model/reducer-master/42/42电机减速机第三版/stl/42波发生器第三版.STL
5.3D Model/reducer-master/42/42电机减速机第三版/stl/42钢轮第三版.STL
5.3D Model/reducer-master/42/42电机减速机第三版/stl/42顶盖第三版.STL
5.3D Model/reducer-master/42/42电机减速机第二版/42减速器总成.SLDASM
5.3D Model/reducer-master/42/42电机减速机第二版/stl/42柔轮第二版.STL
5.3D Model/reducer-master/42/42电机减速机第二版/stl/42钢轮第二版.STL
5.3D Model/reducer-master/42/42电机减速机第二版/stl/42顶盖第二版.3mf
5.3D Model/reducer-master/42/42电机减速机第二版/stl/42顶盖第二版.STL
5.3D Model/reducer-master/42/42电机减速机第四版/42电机总成第四版.SLDDRW
5.3D Model/reducer-master/42/42电机减速机第四版/42电机总成第四版不出轴.SLDDRW
5.3D Model/reducer-master/42/42电机减速机第四版/STL/42底盖第四版.STL
5.3D Model/reducer-master/42/42电机减速机第四版/STL/42柔轮内第四版.STL
5.3D Model/reducer-master/42/42电机减速机第四版/STL/42柔轮第四版.STL
5.3D Model/reducer-master/42/42电机减速机第四版/STL/42柔轮第四版有长轴.STL
5.3D Model/reducer-master/42/42电机减速机第四版/STL/42波发生器第四版.STL
5.3D Model/reducer-master/42/42电机减速机第四版/STL/42波发生器第四版底部中空.STL
5.3D Model/reducer-master/42/42电机减速机第四版/STL/42钢轮第四版.3mf
5.3D Model/reducer-master/42/42电机减速机第四版/STL/42钢轮第四版.STL
5.3D Model/reducer-master/42/42电机减速机第四版/STL/42顶盖第四版.STL
5.3D Model/reducer-master/42/42电机减速机第四版/STL/42顶盖第四版长2mm.STL
5.3D Model/手爪V1.0/夹爪.SLDASM
5.3D Model/手爪V1.0/夹爪.SLDPRT
5.3D Model/拓竹/1-2轴固定座.f3d
5.3D Model/拓竹/机械臂连杆 v0.step
