AIYILIN/Robotic_Arm/5.3D Model/reducer-master/42/42电机减速机第四版/42电机总成第四版.pdf

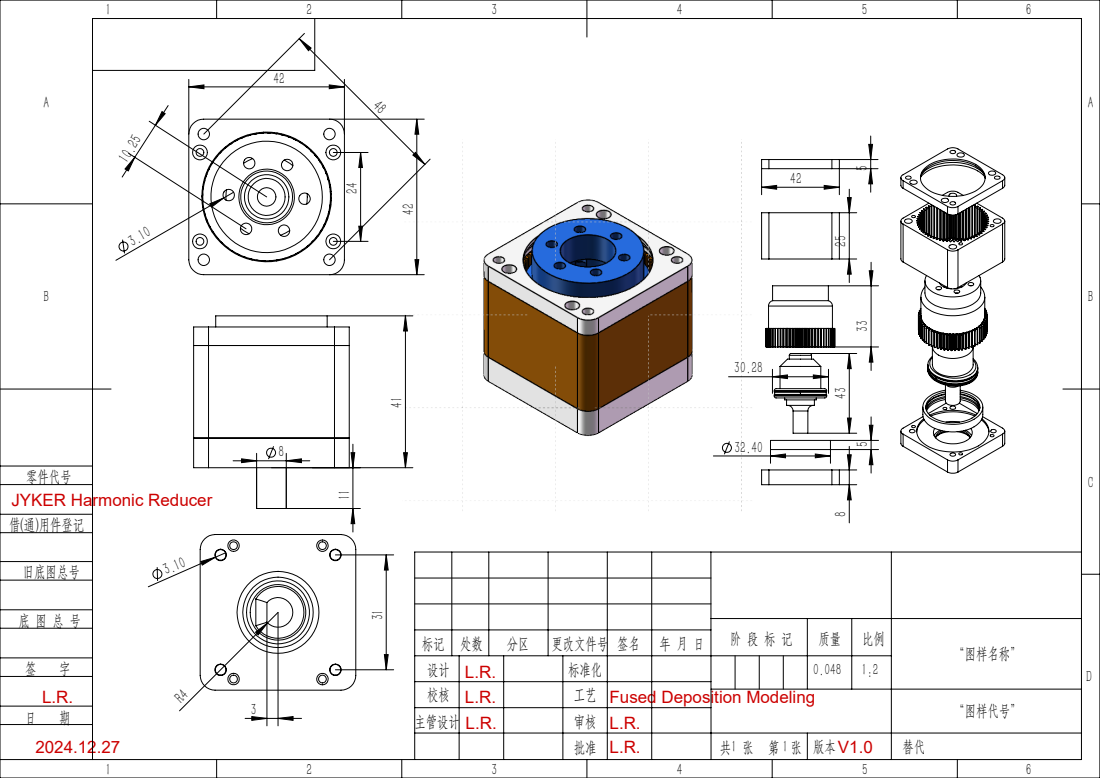
[picture p121: page 1]
Fused Deposition Modeling

零件代号
JYKER Harmonic Reducer
借(通)用件登记

阶 段 标 记 | 质量 | 比例 | “图样名称”

标记 | 处数 | 分区 | 更改文件号 | 签名 | 年 月 日
