AIYILIN/Robotic_Arm/6.Docs/unitree/GO-M8010-6 资料包/GO-M8010-6尺寸图.PDF

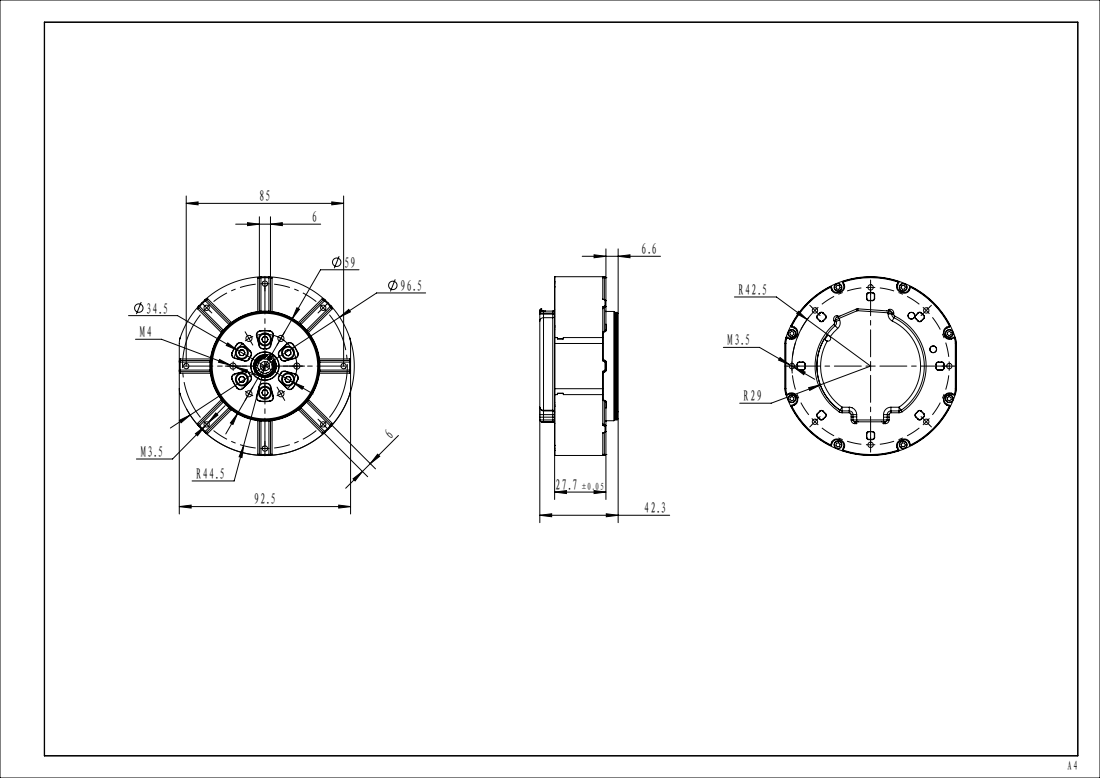
[picture p122: page 1]
