AIYILIN/Robotic_Arm/(list of files, drawings)

Other design files:
6.Docs/unitree/GO-M8010-6电机使用教程/STM32平台教程/GO2电机TTL转485模组资料/1_硬件开发资料_集成库文件/2-集成库源文件/Unitree_HW_LIB.PcbLib
6.Docs/unitree/GO-M8010-6电机使用教程/STM32平台教程/GO2电机TTL转485模组资料/1_硬件开发资料_集成库文件/2-集成库源文件/Unitree_HW_LIB.SchLib
6.Docs/unitree/GO-M8010-6电机使用教程/STM32平台教程/GO2电机TTL转485模组资料/1_硬件开发资料_集成库文件/3-PCB样板文件（封装示例）/Unitree_HW_LIB_DEMO.PcbDoc
6.Docs/unitree/GO-M8010-6电机使用教程/STM32平台教程/GO2电机TTL转485模组资料/2_模组说明文档_附图/1-1D 模组应用接线示例PCB.PcbDoc
