AIYILIN/Robotic_Arm/2.Firmware/Robo_Arm/Core/Src/main.c

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
/* Includes ------------------------------------------------------------------*/
#include "main.h"
#include "cmsis_os.h"
#include "adc.h"
#include "dma.h"
#include "fdcan.h"
#include "memorymap.h"
#include "octospi.h"
#include "spi.h"
#include "tim.h"
#include "usart.h"
#include "usb_device.h"
#include "gpio.h"

/* USER CODE BEGIN Includes */
#include "vofa.h"
#include "w25q64.h"
#include <stdio.h>
#include "arm_math.h"
/* USER CODE END Includes */


/* USER CODE BEGIN PV */
#define W25Qxx_NumByteToTest   	32*1024					// 测试数据的长度，32K

int32_t OSPI_Status ; 		 //检测标志位

uint8_t  W25Qxx_WriteBuffer[W25Qxx_NumByteToTest];		//	写数据数组
uint8_t  W25Qxx_ReadBuffer[W25Qxx_NumByteToTest];		//	读数据数组
/* USER CODE END PV */

void SystemClock_Config(void);
void MX_FREERTOS_Init(void);
/* USER CODE BEGIN 0 */
/***************************************************************************************************
*	函 数 名: OSPI_W25Qxx_Test
*	入口参数: 无
*	返 回 值: OSPI_W25Qxx_OK - 测试成功并通过
*	函数功能: 进行简单的读写测试，并计算速度
*	说    明: 无	
***************************************************************************************************/

int8_t OSPI_W25Qxx_Test(void)		//Flash读写测试
{
    uint32_t i = 0X8000;	// 计数变量
    uint32_t W25Qxx_TestAddr  =	0	;							// 测试地址	
    uint32_t ExecutionTime_Begin;		// 开始时间
    uint32_t ExecutionTime_End;		// 结束时间
    uint32_t ExecutionTime;				// 执行时间	
    float    ExecutionSpeed;			// 执行速度

// 擦除 >>>>>>>>>>>>>>>>>>>>>>>>>>>>>>>>>>>>>>>>>>>>>>>>>>>>>>>>>>>>>>>>>>>>>>>>>>>>>>>>>>>>>>   
    
    
    ExecutionTime_Begin 	= HAL_GetTick();	// 获取 systick 当前时间，单位ms
    OSPI_Status 			= OSPI_W25Qxx_BlockErase_32K(W25Qxx_TestAddr);	// 擦除32K字节
    ExecutionTime_End		= HAL_GetTick();	// 获取 systick 当前时间，单位ms
    
    ExecutionTime = ExecutionTime_End - ExecutionTime_Begin; // 计算擦除时间，单位ms
    
    if( OSPI_Status == OSPI_W25Qxx_OK )
    {
        printf ("\r\nW25Q64 erase succeed, time: %d ms\r\n",ExecutionTime);		
    }
    else
    {
        printf ("\r\n erase error!!!!!  ERROR CODE:%d\r\n",OSPI_Status);
        while (1);
    }   
    
// 写入 >>>>>>>>>>>>>>>>>>>>>>>>>>>>>>>>>>>>>>>>>>>>>>>>>>>>>>>>>>>>>>>>>>>>>>>>>>>>>>>>>>>>>>

    for(i=0;i<W25Qxx_NumByteToTest;i++)  //先将数据写入数组
    {
        W25Qxx_WriteBuffer[i] = i;
    }
    ExecutionTime_Begin 	= HAL_GetTick();	// 获取 systick 当前时间，单位ms
    OSPI_Status				= OSPI_W25Qxx_WriteBuffer(W25Qxx_WriteBuffer,W25Qxx_TestAddr,W25Qxx_NumByteToTest); // 写入数据
    ExecutionTime_End		= HAL_GetTick();	// 获取 systick 当前时间，单位ms
    
    ExecutionTime  = ExecutionTime_End - ExecutionTime_Begin; 		// 计算擦除时间，单位ms
    ExecutionSpeed = (float)W25Qxx_NumByteToTest / ExecutionTime ; // 计算写入速度，单位 KB/S
    if( OSPI_Status == OSPI_W25Qxx_OK )
    {
        printf ("\r\nwrite succeed, data size: %d KB, time: %d ms, speed: %.2f KB/s\r\n",W25Qxx_NumByteToTest/1024,ExecutionTime,ExecutionSpeed);		
    }
    else
    {
        printf ("\r\nwrite error!!!!!  error code: %d\r\n",OSPI_Status);
        while (1);
    }	
    
// 读取	>>>>>>>>>>>>>>>>>>>>>>>>>>>>>>>>>>>>>>>>>>>>>>>>>>>>>>>>>>>>>>>>>>>>>>>>>>>>>>>>>>>>>> 

    
    ExecutionTime_Begin 	= HAL_GetTick();	// 获取 systick 当前时间，单位ms	
    OSPI_Status				= OSPI_W25Qxx_ReadBuffer(W25Qxx_ReadBuffer,W25Qxx_TestAddr,W25Qxx_NumByteToTest);	// 读取数据
    ExecutionTime_End		= HAL_GetTick();	// 获取 systick 当前时间，单位ms
    
    ExecutionTime  = ExecutionTime_End - ExecutionTime_Begin; 					// 计算擦除时间，单位ms
    ExecutionSpeed = (float)W25Qxx_NumByteToTest/1024/1024 / ExecutionTime*1000 ; 	// 计算读取速度，单位 MB/S 
    
    if( OSPI_Status == OSPI_W25Qxx_OK )
    {
        printf ("\r\nread succeed, size: %d KB, time: %d ms, speed: %.2f MB/s \r\n",W25Qxx_NumByteToTest/1024,ExecutionTime,ExecutionSpeed);		
    }
    else
    {
        printf ("\r\nread error!!!!!  error code:%d\r\n",OSPI_Status);
        while (1);
    }   
// 数据校验 >>>>>>>>>>>>>>>>>>>>>>>>>>>>>>>>>>>>>>>>>>>>>>>>>>>>>>>>>>>>>>>>>>>>>>>>>>>>>>>>>>>>>>   
    
    for(i=0;i<W25Qxx_NumByteToTest;i++)	//验证读出的数据是否等于写入的数据
    {
        if( W25Qxx_WriteBuffer[i] != W25Qxx_ReadBuffer[i] )	//如果数据不相等，则返回0	
        {
            printf ("\r\ndata check error!!!!!pos: %d\r\n",i);	
            while(1);
        }
    }   
    printf ("\r\ncheck pass!!!!!\r\n"); 
    
// 读取整片Flash的数据，用以测试速度 >>>>>>>>>>>>>>>>>>>>>>>>>>>>>>>>>>>>>>>>>>>>>>>>>>>>>>>>>>>>>>
    
    printf ("\r\n*****************************************************************************************************\r\n");		
    printf ("\r\nIn the above test, the data read is relatively small and takes a short time. In addition, the minimum unit of measurement is ms, and the calculated reading speed has a large error.\r\n");		
    printf ("\r\nNext, read the entire flash data to test the speed. The speed error obtained in this way is relatively small.\r\n");		
    printf ("\r\nread start>>>>\r\n");		
    ExecutionTime_Begin 	= HAL_GetTick();	// 获取 systick 当前时间，单位ms		
    
    for(i=0;i<W25Qxx_FlashSize/(W25Qxx_NumByteToTest);i++)	// 每次读取 W25Qxx_NumByteToTest 字节的数据
    {
        OSPI_Status     = OSPI_W25Qxx_ReadBuffer(W25Qxx_ReadBuffer,W25Qxx_TestAddr,W25Qxx_NumByteToTest);	// 读取数据
        W25Qxx_TestAddr = W25Qxx_TestAddr + W25Qxx_NumByteToTest;		
    }
    ExecutionTime_End   = HAL_GetTick();	// 获取 systick 当前时间，单位ms
    
    ExecutionTime       = ExecutionTime_End - ExecutionTime_Begin; 								// 计算擦除时间，单位ms
    ExecutionSpeed      = (float)W25Qxx_FlashSize/1024/1024 / ExecutionTime*1000  ; 	// 计算读取速度，单位 MB/S 

    if( OSPI_Status == OSPI_W25Qxx_OK )
    {
        printf ("\r\nread succeed, size: %d MB, time: %d ms, speed: %.2f MB/s \r\n",W25Qxx_FlashSize/1024/1024,ExecutionTime,ExecutionSpeed);		
    }
    else
    {
        printf ("\r\nread error!!!!!  error code:%d\r\n",OSPI_Status);
        while (1);
    }	
    
    return OSPI_W25Qxx_OK ;  // 测试通过				
    
}
/* USER CODE END 0 */

/**
  * @brief  The application entry point.
  * @retval int
  */
int main(void)
{

  /* MCU Configuration--------------------------------------------------------*/

  /* Reset of all peripherals, Initializes the Flash interface and the Systick. */
  HAL_Init();

  /* Configure the system clock */
  SystemClock_Config();

  /* Initialize all configured peripherals */
  MX_GPIO_Init();
  MX_DMA_Init();
  MX_ADC1_Init();
  MX_TIM12_Init();
  MX_SPI6_Init();
  MX_SPI2_Init();
  MX_TIM3_Init();
  MX_USART1_UART_Init();
  MX_USART2_UART_Init();
  MX_UART7_Init();
  MX_USART10_UART_Init();
  MX_FDCAN1_Init();
  MX_FDCAN2_Init();
  MX_FDCAN3_Init();
  MX_OCTOSPI2_Init();
  MX_UART9_Init();
  /* USER CODE BEGIN 2 */
//    OSPI_W25Qxx_Init();     // 初始化OSPI和W25Q64
//    
//    OSPI_W25Qxx_Test();     // Flash读写测试
  /* USER CODE END 2 */

  /* Call init function for freertos objects (in cmsis_os2.c) */
  MX_FREERTOS_Init();

  /* Start scheduler */
  osKernelStart();

  /* We should never get here as control is now taken by the scheduler */

  /* Infinite loop */
  /* USER CODE BEGIN WHILE */
  while (1)
  {
//	  vofa_start();

    /* USER CODE END WHILE */

    /* USER CODE BEGIN 3 */
  }
  /* USER CODE END 3 */
}

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
/**
  * @brief  Period elapsed callback in non blocking mode
  * @note   This function is called  when TIM23 interrupt took place, inside
  * HAL_TIM_IRQHandler(). It makes a direct call to HAL_IncTick() to increment
  * a global variable "uwTick" used as application time base.
  * @param  htim : TIM handle
  * @retval None
  */
void HAL_TIM_PeriodElapsedCallback(TIM_HandleTypeDef *htim)
{
  if (htim->Instance == TIM23) {
    HAL_IncTick();
  }
}

/**
  * @brief  This function is executed in case of error occurrence.
  * @retval None
  */
void Error_Handler(void)
{
  /* USER CODE BEGIN Error_Handler_Debug */
  /* User can add his own implementation to report the HAL error return state */
  __disable_irq();
  while (1)
  {
  }
  /* USER CODE END Error_Handler_Debug */
}

#ifdef  USE_FULL_ASSERT
/**
  * @brief  Reports the name of the source file and the source line number
  *         where the assert_param error has occurred.
  * @param  file: pointer to the source file name
  * @param  line: assert_param error line source number
  * @retval None
  */
void assert_failed(uint8_t *file, uint32_t line)
{
  /* USER CODE BEGIN 6 */
  /* User can add his own implementation to report the file name and line number,
     ex: printf("Wrong parameters value: file %s on line %d\r\n", file, line) */
  /* USER CODE END 6 */
}
#endif /* USE_FULL_ASSERT */
