AIYILIN/Robotic_Arm/2.Firmware/Robo_Arm/App/kinematic_task.c

#include "kinematic_task.h"
#include "arm_kinematics.h"

// #include "6dof_kinematic.h"
// #include "dof6_c_interface.h"



// 计算结果存储
float fk_angle[6] = {0};
float fk_pos_eul[6] = {0};




void KinematicsTask_Entry(void const *argument)
{
  /* USER CODE BEGIN KinematicsTask_Entry */

  canfd_filter(&hfdcan1);
  canfd_filter(&hfdcan3);

  Init_Motor_All();
  
  Arm_joint_init_para_set(arm_joint);
  joint_T_profilel_param_init(joint_T_profilel);

  osDelay(3000);
  
  Arm_joint_motion_para_set(arm_joint);
  osDelay(2000);
  int court = 0;
  for (;;)
  {
    // 计算正运动学
    forward_kinematics(fk_angle, fk_pos_eul);

    // pose_and_xyzEulerAngles_to_matrix(&XYZ_euler_angles,&target_pose);
    // char num_sols = inverse_kinematics(&target_pose, &default_tool, links, ik_solutions);
 
    // 更新所有关节的轨迹
    for (int i = 0; i < 6; i++) 
    {
        Update_T_Profile(&joint_T_profilel[i], 0.003f);  // dt=5ms  
    }   

    for (int i = 0; i < 6; i++) 
    {
        arm_joint[i].pos = joint_T_profilel[i].pos_current;     // 使用平滑后的位置
    }

    

    HAL_GPIO_TogglePin(GPIOA, GPIO_PIN_0); 

    
    vofa_send_data(1,joint_T_profilel[0].pos_current);
    vofa_send_data(2,joint_T_profilel[1].pos_current - JOINT_2_INIT_POS);
    vofa_send_data(3,joint_T_profilel[2].pos_current - JOINT_3_INIT_POS);
    vofa_send_data(4,joint_T_profilel[3].pos_current);
    vofa_send_data(5,joint_T_profilel[4].pos_current);
    vofa_send_data(6,joint_T_profilel[5].pos_current);
    vofa_sendframetail();

    osDelay(1);
  }
  /* USER CODE END KinematicsTask_Entry */
}


 // char debug_buf[1024];
        // for (int i = 0; i < 8; i++) 
        // {
        //     // 使用固定宽度+符号对齐格式
        //     snprintf(debug_buf, sizeof(debug_buf),
        //         "SOL:%02d | J1:%10.2f | J2:%10.2f | J3:%10.2f | J4:%10.2f | J5:%10.2f | J6:%10.2f | V:%d\r\n",
        //         i+1,
        //         ik_solutions[i].angles[0],
        //         ik_solutions[i].angles[1],
        //         ik_solutions[i].angles[2],
        //         ik_solutions[i].angles[3],
        //         ik_solutions[i].angles[4],
        //         ik_solutions[i].angles[5],
        //         ik_solutions[i].valid);

        //     HAL_UART_Transmit(&huart1, (uint8_t*)debug_buf, strlen(debug_buf), 10);
        //     osDelay(100);
        // }


float joint_os_delay = 20;
void joints_euler_move_text(void) 
{
    // const float joint_angles[1201][6] = 
    // {
    //     { -46.80995719, -55.75073619, 1.43242925, -30.23254761, 111.44620565, -102.81284039 },
    //     { -46.78418335, -55.70113137, 1.33690995, -30.15260013, 111.44332209, -102.76056666 },
    //     { -46.75838066, -55.65153827, 1.24155590, -30.07258811, 111.44027529, -102.70817434 },
    //     { -46.73255339, -55.60197749, 1.14640083, -29.99252679, 111.43707329, -102.65565809 },
    //     { -46.70670159, -55.55244867, 1.05144421, -29.91241655, 111.43371588, -102.60301856 },
    //     { -46.68082532, -55.50295146, 0.95668547, -29.83225772, 111.43020283, -102.55025639 },
    //     { -46.65492464, -55.45348551, 0.86212409, -29.75205068, 111.42653393, -102.49737223 },
    //     { -46.62899960, -55.40405046, 0.76775952, -29.67179577, 111.42270896, -102.44436671 },
    //     { -46.60305025, -55.35464596, 0.67359124, -29.59149336, 111.41872771, -102.39124048 },
    //     { -46.57707666, -55.30527168, 0.57961872, -29.51114380, 111.41458996, -102.33799418 },
    //     { -46.55107887, -55.25592727, 0.48584144, -29.43074745, 111.41029548, -102.28462845 },
    //     { -46.52505695, -55.20661240, 0.39225889, -29.35030468, 111.40584407, -102.23114393 },
    //     { -46.49901094, -55.15732672, 0.29887057, -29.26981584, 111.40123549, -102.17754125 },
    //     { -46.47294092, -55.10806992, 0.20567596, -29.18928130, 111.39646952, -102.12382106 },
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
    joint_T_profilel[2].pos_target = JOINT_3_INIT_POS + 65;
    joint_T_profilel[3].pos_target = JOINT_4_INIT_POS - 90;
    joint_T_profilel[4].pos_target = JOINT_5_INIT_POS - 45;
    joint_T_profilel[5].pos_target = JOINT_6_INIT_POS ;

  }
  osDelay(6500);

  if (joints_init_flag == 1)
  {
    joint_T_profilel[0].pos_target = JOINT_1_INIT_POS;
    joint_T_profilel[1].pos_target = JOINT_2_INIT_POS;
    joint_T_profilel[2].pos_target = JOINT_3_INIT_POS;
    joint_T_profilel[3].pos_target = JOINT_4_INIT_POS;
    joint_T_profilel[4].pos_target = JOINT_5_INIT_POS;
    joint_T_profilel[5].pos_target = JOINT_6_INIT_POS;
  }
}
