AIYILIN/Robotic_Arm/2.Firmware/Robo_Arm/Algorithm/inc/6dof_kinematic.h

// 6dof_kinematic.h
#ifndef DOF6_KINEMATIC_H
#define DOF6_KINEMATIC_H



#ifdef __cplusplus  // 确保仅在C++模式下编译类定义


class DOF6Kinematic
{
private:
    const float RAD_TO_DEG = 57.295777754771045f;

    // DH parameters
    struct ArmConfig_t
    {
        float L_BASE;
        float D_BASE;
        float L_ARM;
        float L_FOREARM;
        float D_ELBOW;
        float L_WRIST;
    };
    ArmConfig_t armConfig;

    float DH_matrix[6][4] = {0}; // home,d,a,alpha
    float L1_base[3] = {0};
    float L2_arm[3] = {0};
    float L3_elbow[3] = {0};
    float L6_wrist[3] = {0};

    float l_se_2;
    float l_se;
    float l_ew_2;
    float l_ew;
    float atan_e;

public:
    struct Joint6D_t
    {
        Joint6D_t()
        = default;

        Joint6D_t(float a1, float a2, float a3, float a4, float a5, float a6)
            : a{a1, a2, a3, a4, a5, a6}
        {}

        float a[6];

        friend Joint6D_t operator-(const Joint6D_t &_joints1, const Joint6D_t &_joints2);
    };

    struct Pose6D_t
    {
        Pose6D_t()
        = default;

        Pose6D_t(float x, float y, float z, float a, float b, float c)
            : X(x), Y(y), Z(z), A(a), B(b), C(c), hasR(false)
        {}

        float X{}, Y{}, Z{};
        float A{}, B{}, C{};
        float R[9]{};

        // if Pose was calculated by FK then it's true automatically (so that no need to do extra calc),
        // otherwise if manually set params then it should be set to false.
        bool hasR{};
    };

    struct IKSolves_t
    {
        Joint6D_t config[8];
        char solFlag[8][3];
    };

    DOF6Kinematic(float L_BS, float D_BS, float L_AM, float L_FA, float D_EW, float L_WT);

    bool SolveFK(const Joint6D_t &_inputJoint6D, Pose6D_t &_outputPose6D);

    bool SolveIK(const Pose6D_t &_inputPose6D, const Joint6D_t &_lastJoint6D, IKSolves_t &_outputSolves);
};

#endif // __cplusplus

#endif //DOF6_KINEMATIC_SOLVER_H
