AIYILIN/Robotic_Arm/2.Firmware/Robo_Arm/App/safe_monitor_task.c

#include "safe_monitor_task.h"


float vbus = 0;
volatile uint16_t adc_val[2];
uint8_t key_status = 0;

SAFE_MONITOR joint_torque_limit = 
{
    .joint_torque[0] = 0,
    .joint_torque[1] = 0,
    .joint_torque[2] = 0,
    // .joint_torque[3] = 0,
    .joint_torque[4] = 0,

    .joint_torque_safelimit[0] = 5.8f,
    .joint_torque_safelimit[1] = 5.8f,
    .joint_torque_safelimit[2] = 5.8f,
    .joint_torque_safelimit[3] = 5.8f,//
    .joint_torque_safelimit[4] = 5.8f,
    .joint_torque_safelimit[5] = 5.8f,//
};


void SafeMonitorTask_Entry(void const * argument)
{
    /* USER CODE BEGIN KeyTask_Entry */
    
    BSP_Buzzer_Init();
    HAL_ADCEx_Calibration_Start(&hadc1, ADC_CALIB_OFFSET, ADC_SINGLE_ENDED);
    HAL_ADC_Start_DMA(&hadc1, (uint32_t *)adc_val,2);
    osDelay(100);
    
    /* Infinite loop */
    for(;;)
    {

        motor_torque_Watchdog(&joint_torque_limit);

        if (BSP_UserKey_Detect() == BUTTON_PRESSED)
        {   
            BSP_Buzzer_Toggle();
            joints_init_flag = ! joints_init_flag;
            if(joints_init_flag)
            {
                joint_T_profilel[0].pos_target = JOINT_1_INIT_POS;    //-3~3
                joint_T_profilel[1].pos_target = JOINT_2_INIT_POS;    //-8~8
                joint_T_profilel[2].pos_target = JOINT_3_INIT_POS;    //-4~14
                joint_T_profilel[3].pos_target = JOINT_4_INIT_POS;    
                joint_T_profilel[4].pos_target = JOINT_5_INIT_POS;    //-2.7~2.7
                joint_T_profilel[5].pos_target = JOINT_6_INIT_POS;    
            }
        }
        vbus = (adc_val[0]*3.3f/65535)*11.0f;

        // PS2_ScanKey(&my_ps2,0);
        
        osDelay(10);
    }
    /* USER CODE END KeyTask_Entry */
}


/**
 * @brief 电机扭矩安全检测
 * @param safe_monitor 安全检测结构体
 * @return 无
 */
void motor_torque_Watchdog(SAFE_MONITOR *safe_monitor)
{
    safe_monitor->joint_torque[0] = Motor3.Torque;
    safe_monitor->joint_torque[1] = go_rec2.T;
    safe_monitor->joint_torque[2] = Motor1.Torque;
    safe_monitor->joint_torque[3] = go_rec3.T;

    for (int i = 0; i < 4; i++)
    {
        if(fabsf(safe_monitor->joint_torque[i]) > safe_monitor->joint_torque_safelimit[i])
        {
            BSP_Buzzer_On();
            arm_joint[i].kp = 0;
            arm_joint[i].kw = 0;
            arm_joint[i].w = 0;
            arm_joint[i].torque = 0;
            
        }
    }
    
}
