AIYILIN/Robotic_Arm/2.Firmware/Robo_Arm/Algorithm/inc/user_lib.h

#ifndef USER_LIB_H
#define USER_LIB_H
//#include "struct_typedef.h"
#include <stdint.h>

#define ABS(x)		((x>0)? (x): (-x)) 

//typedef __packed struct
typedef  struct
{
    float input;        //输入数据
    float out;          //输出数据
    float min_value;    //限幅最小值
    float max_value;    //限幅最大值
    float frame_period; //时间间隔
} __attribute__((packed)) ramp_function_source_t;


//typedef __packed struct
typedef  struct
{
    float input;        //输入数据
    float out;          //滤波输出的数据
    float num[1];       //滤波参数
    float frame_period; //滤波的时间间隔 单位 s
} __attribute__((packed)) first_order_filter_type_t;
//快速开方
extern float invSqrt(float num);

//斜波函数初始化
void ramp_init(ramp_function_source_t *ramp_source_type, float frame_period, float max, float min);

//斜波函数计算
void ramp_calc(ramp_function_source_t *ramp_source_type, float input);
//一阶滤波初始化
extern void first_order_filter_init(first_order_filter_type_t *first_order_filter_type, float frame_period, const float num[1]);
//一阶滤波计算
extern void first_order_filter_cali(first_order_filter_type_t *first_order_filter_type, float input);
//绝对限制
extern void abs_limit(float *num, float Limit);
//判断符号位
extern float sign(float value);
//浮点死区
extern float float_deadline(float Value, float minValue, float maxValue);
//int26死区
extern int16_t int16_deadline(int16_t Value, int16_t minValue, int16_t maxValue);
//限幅函数
extern float float_constrain(float Value, float minValue, float maxValue);
//限幅函数
extern int16_t int16_constrain(int16_t Value, int16_t minValue, int16_t maxValue);
//循环限幅函数
extern float loop_float_constrain(float Input, float minValue, float maxValue);
//角度 °限幅 180 ~ -180
extern float theta_format(float Ang);

//弧度格式化为-PI~PI
#define rad_format(Ang) loop_float_constrain((Ang), -PI, PI)

#endif
