AIYILIN/Robotic_Arm/2.Firmware/Robo_Arm/Bsp/inc/bsp_user_key.h

#ifndef __BSP_USER_KEY_H__
#define __BSP_USER_KEY_H__

#include "gpio.h"

#define BUTTON_NOT_PRESSED      0
#define BUTTON_PRESSED          1

typedef enum
{
    NO_DETECT,
    DETECTING,
    DETECTED
}KeyState;

int8_t BSP_UserKey_Detect(void);

extern uint8_t Key_Press ;

#endif
