AIYILIN/Robotic_Arm/(commit log)

2025-01-31 all add
    [1-1D 模组应用接线示例PCB.PcbDoc, 1-2轴固定座.f3d, 1-2轴固定座.step, 2-3轴固定座.step, 28电机减速电机.SLDASM, 3-4轴固定座.step, 42减速器总成.SLDASM, 42减速器总成.STEP]
2025-02-06 add cnc models
    [cnc2-3.step, cnc3-4.step]
2025-02-09 updata 6 joints dh
2025-02-12 add 3-4joint conneter
    [3-4轴连接.step]
2025-04-02 update joint-t para
2025-04-02 add joint 4 and 6 key to zero function
2025-04-08 updata 6 joints
2025-05-11 update matlab/stm32 ik and fk funtion
2025-05-11 add stm32's tool_ik funtion
2025-05-12 add stm32's euler ik funtion
    [JointAngles_20250512_184740.xlsx, JointAngles_20250512_184922.xlsx, JointAngles_20250512_193927.xlsx, JointAngles_20250512_222232.xlsx]
2025-05-13 add hsp lvgl
    [T8螺母.SLDPRT, modules.cfg, 丝杠42电机.SLDPRT, 侧杆1.SLDPRT, 侧杆2.SLDPRT, 右外壳.SLDPRT, 夹爪.SLDASM, 夹爪.SLDPRT]
2025-05-16 add arm_guiji
    [JointAngles_20250512_184740.xlsx, JointAngles_20250512_184922.xlsx, JointAngles_20250512_193927.xlsx, JointAngles_20250512_222232.xlsx, joint_angles_20250516_154820.xlsx]
