AIYILIN/Robotic_Arm/(notices)

Notices in the files:
6.Docs/unitree/GO-M8010-6电机使用教程/STM32平台教程/STM32F767ZITx控制电机例程/Core/Inc/main.h:
Copyright (c) 2023 STMicroelectronics.
All rights reserved.
This software is licensed under terms that can be found in the LICENSE file
2.Firmware/Robo_Arm/Core/Src/main.c:
Copyright (c) 2024 STMicroelectronics.
